snowhoster/MAVLinkController/docs/images/thumb_xh254_connectors.jpg

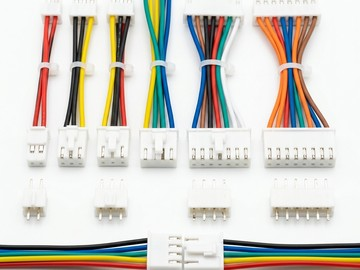
docs/images/thumb_xh254_connectors.jpg
