snowhoster/MAVLinkController/docs/images/thumb_arduino_uno.jpg

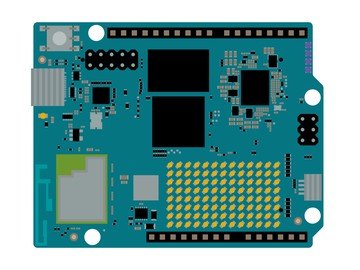
docs/images/thumb_arduino_uno.jpg
