snowhoster/MAVLinkController/docs/images/apem_sn.jpg

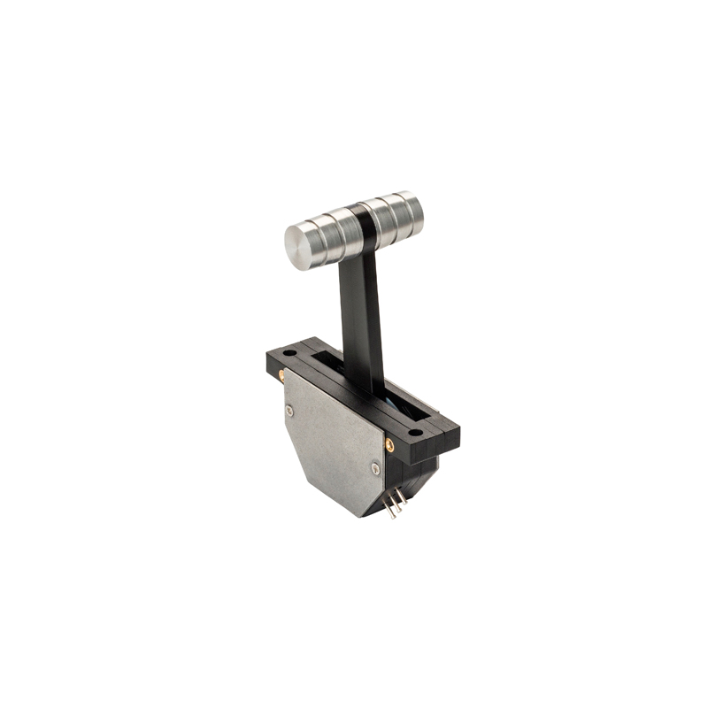
docs/images/apem_sn.jpg
