snowhoster/MAVLinkController/docs/images/arduino_uno.jpg

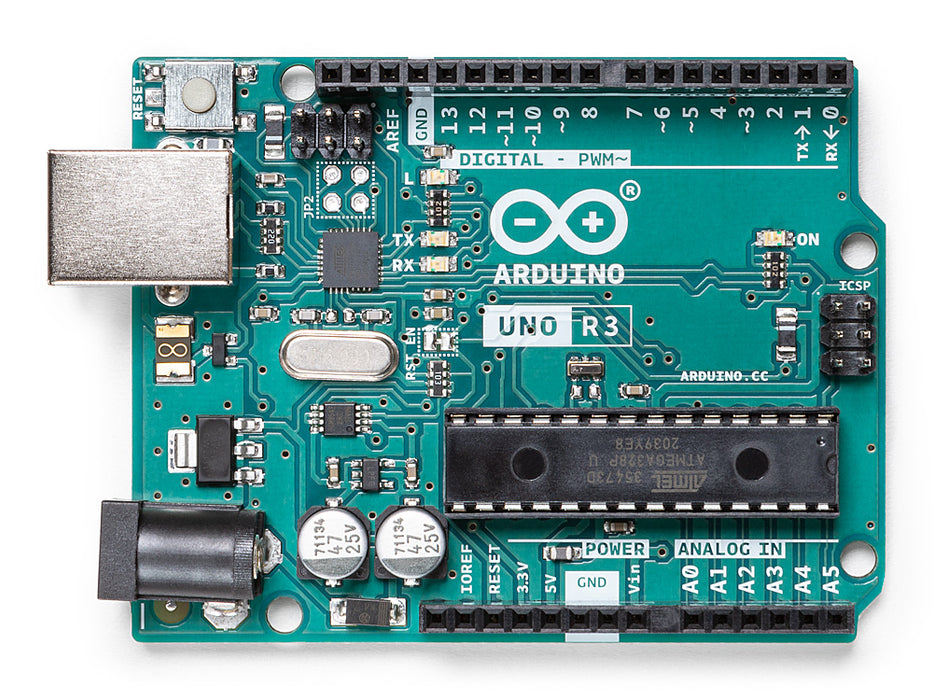
docs/images/arduino_uno.jpg
