snowhoster/MAVLinkController/docs/images/battery_18650.jpg

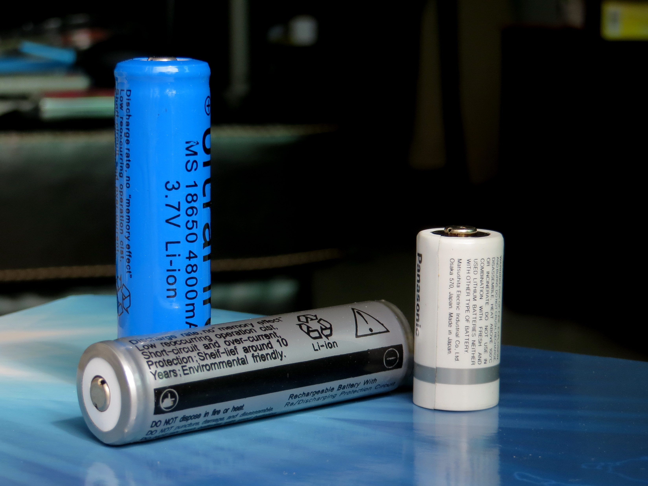
docs/images/battery_18650.jpg
