snowhoster/MAVLinkController/docs/images/battery_ups_module.jpg

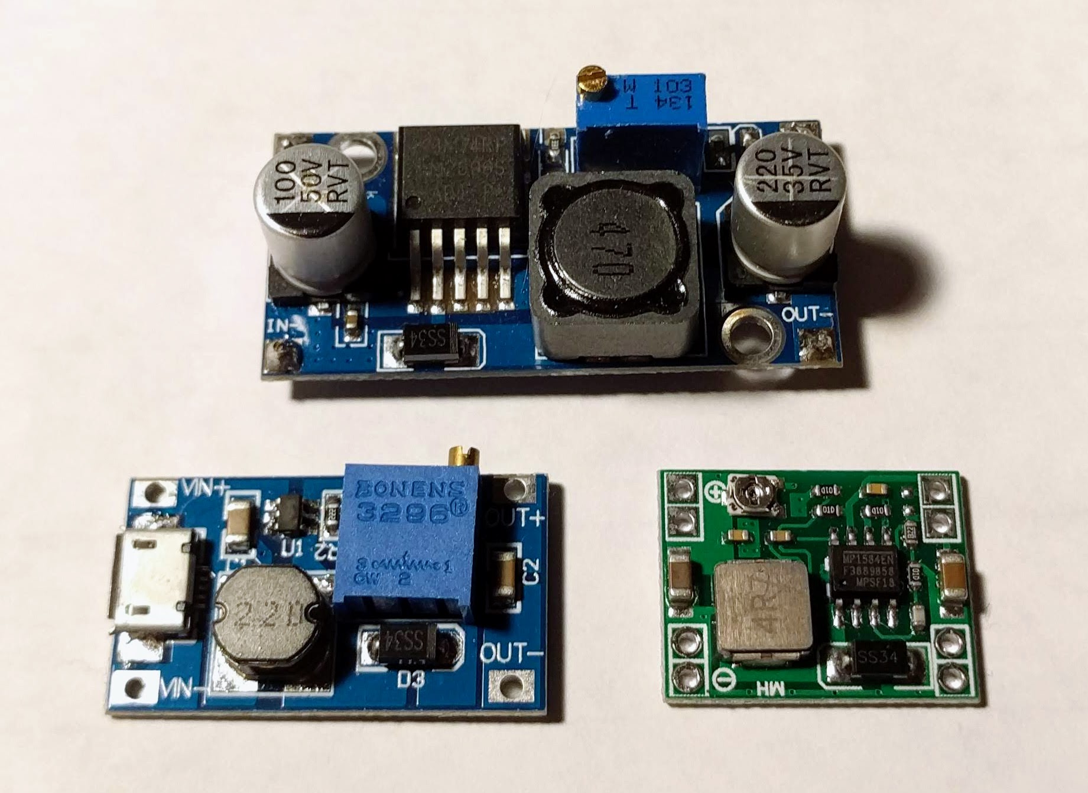
docs/images/battery_ups_module.jpg
