snowhoster/MAVLinkController/docs/images/capacitors.png

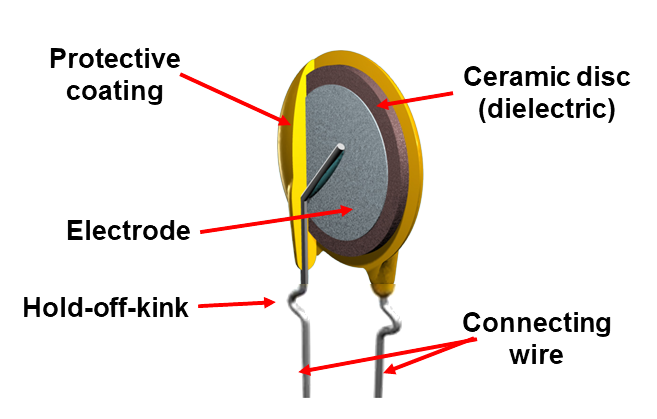
docs/images/capacitors.png
