snowhoster/MAVLinkController/docs/images/estop_button.jpg

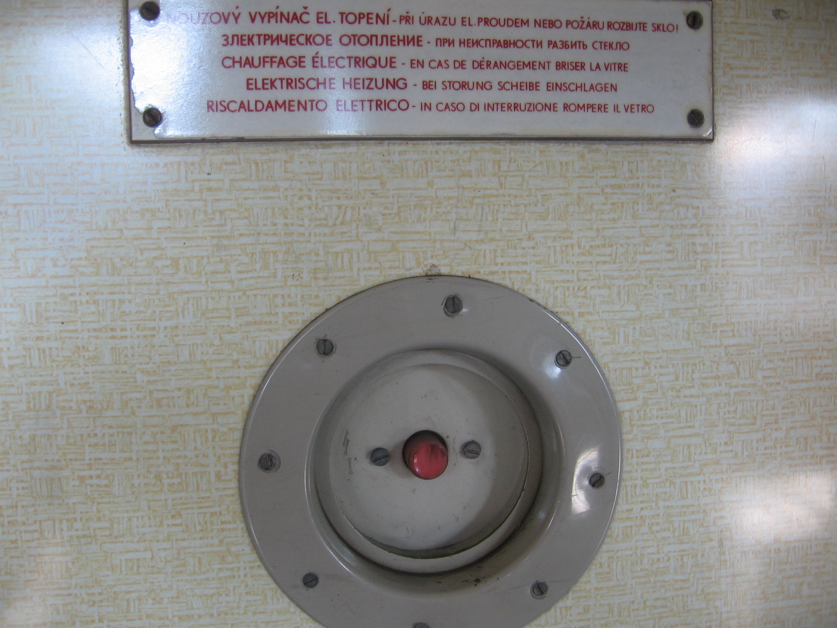
docs/images/estop_button.jpg
