snowhoster/MAVLinkController/docs/images/lcd1602.jpg

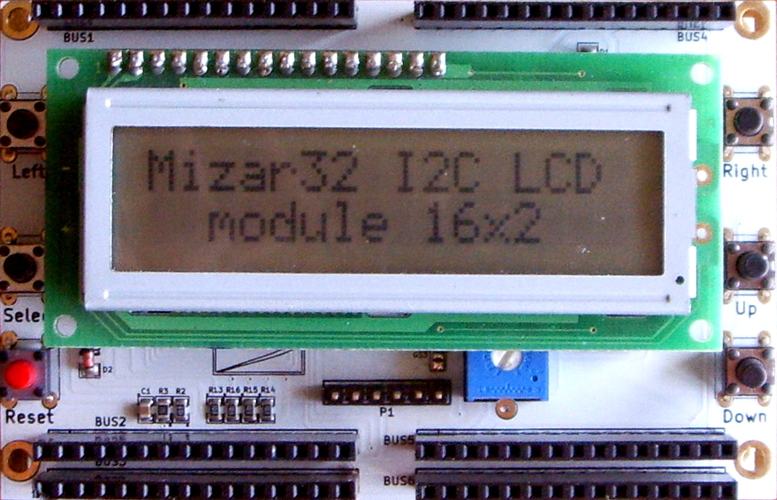
docs/images/lcd1602.jpg
