snowhoster/MAVLinkController/docs/images/mirotek_lcd_32.jpg

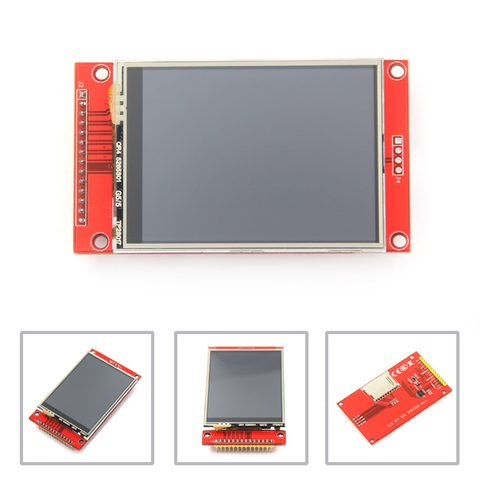
docs/images/mirotek_lcd_32.jpg
