snowhoster/MAVLinkController/docs/images/perfboard.jpg

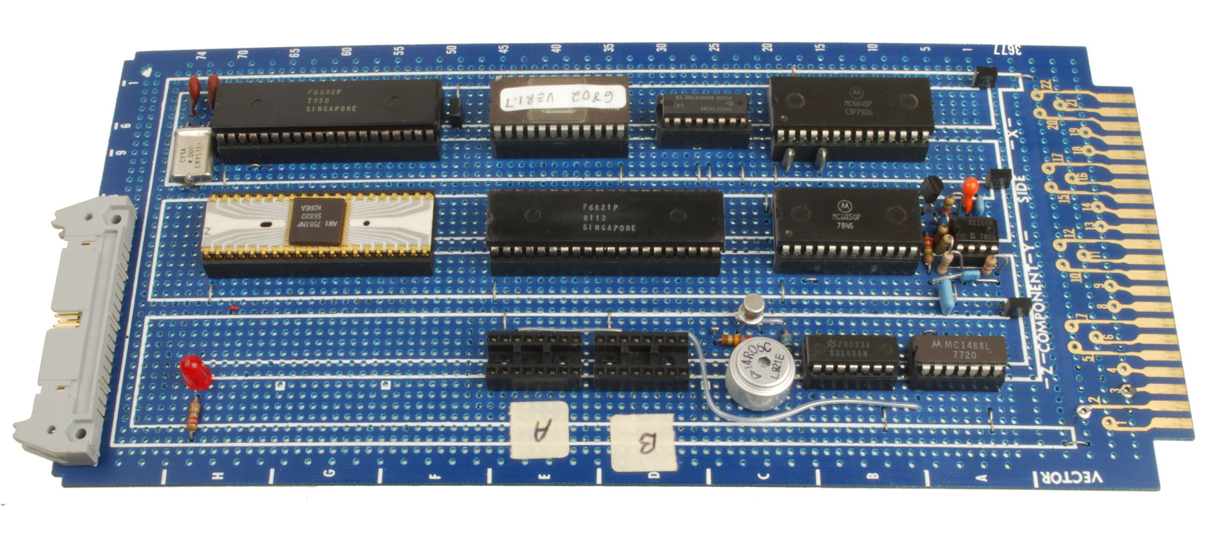
docs/images/perfboard.jpg
