snowhoster/MAVLinkController/docs/images/potentiometer.jpg

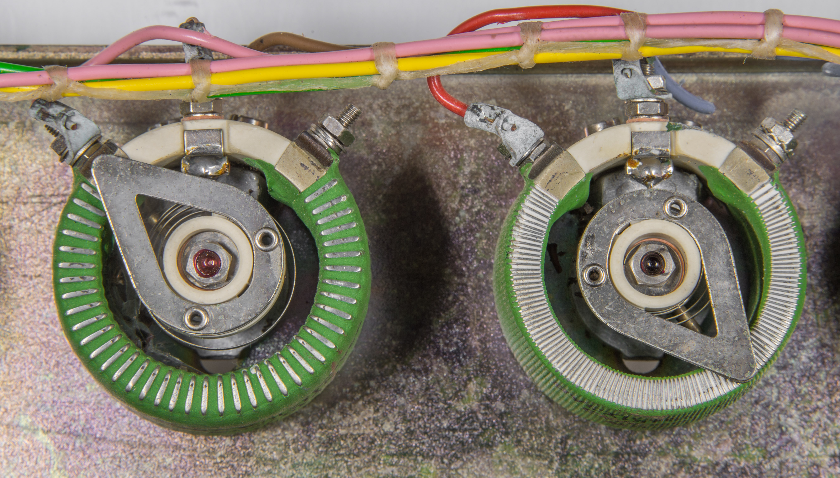
docs/images/potentiometer.jpg
