snowhoster/MAVLinkController/docs/images/resistors.jpg

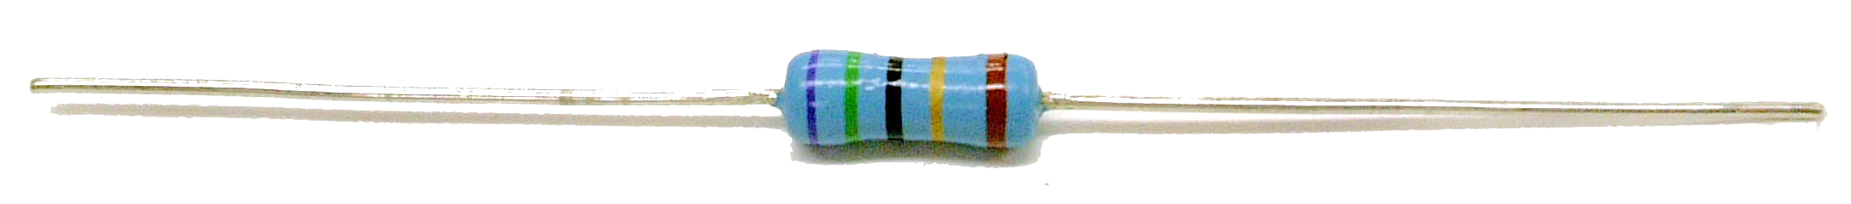
docs/images/resistors.jpg
