snowhoster/MAVLinkController/docs/images/thumb_apem_sn.jpg

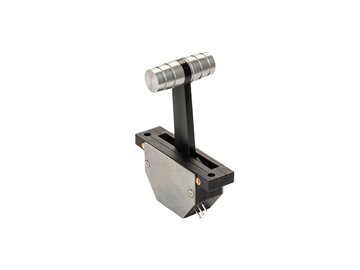
docs/images/thumb_apem_sn.jpg
