snowhoster/MAVLinkController/docs/images/thumb_battery_18650.jpg

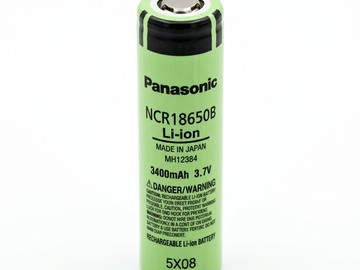
docs/images/thumb_battery_18650.jpg
