snowhoster/MAVLinkController/docs/images/thumb_battery_ups_module.jpg

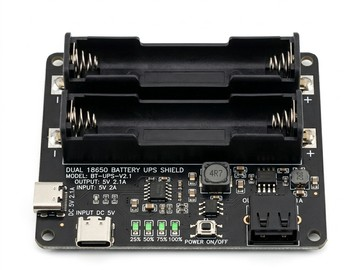
docs/images/thumb_battery_ups_module.jpg
