snowhoster/MAVLinkController/docs/images/thumb_capacitors.jpg

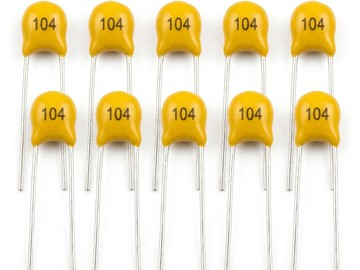
docs/images/thumb_capacitors.jpg
