snowhoster/MAVLinkController/docs/images/thumb_estop_button.jpg

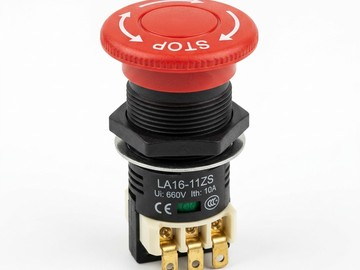
docs/images/thumb_estop_button.jpg
