snowhoster/MAVLinkController/docs/images/thumb_lcd1602.jpg

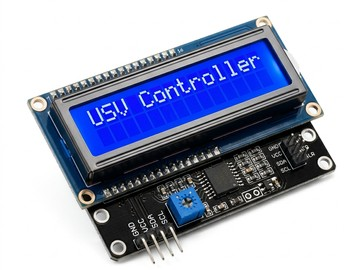
docs/images/thumb_lcd1602.jpg
