snowhoster/MAVLinkController/docs/images/thumb_perfboard.jpg

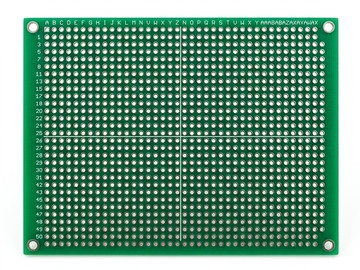
docs/images/thumb_perfboard.jpg
