snowhoster/MAVLinkController/docs/images/thumb_potentiometer.jpg

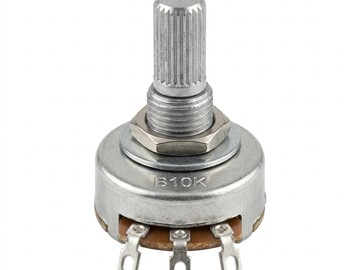
docs/images/thumb_potentiometer.jpg
