snowhoster/MAVLinkController/docs/images/thumb_resistors.jpg

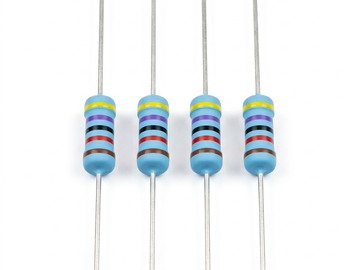
docs/images/thumb_resistors.jpg
