snowhoster/MAVLinkController/docs/images/thumb_typec_cable.jpg

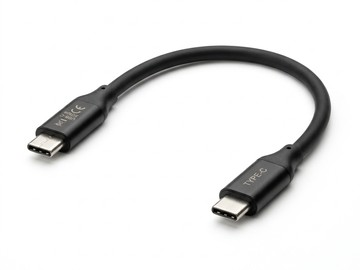
docs/images/thumb_typec_cable.jpg
