snowhoster/MAVLinkController/docs/images/typec_cable.jpg

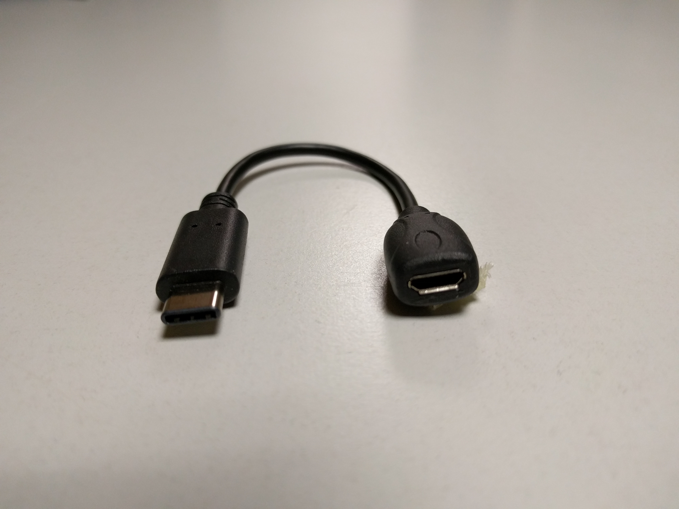
docs/images/typec_cable.jpg
