snowhoster/MAVLinkController/docs/images/xh254_connectors.jpg

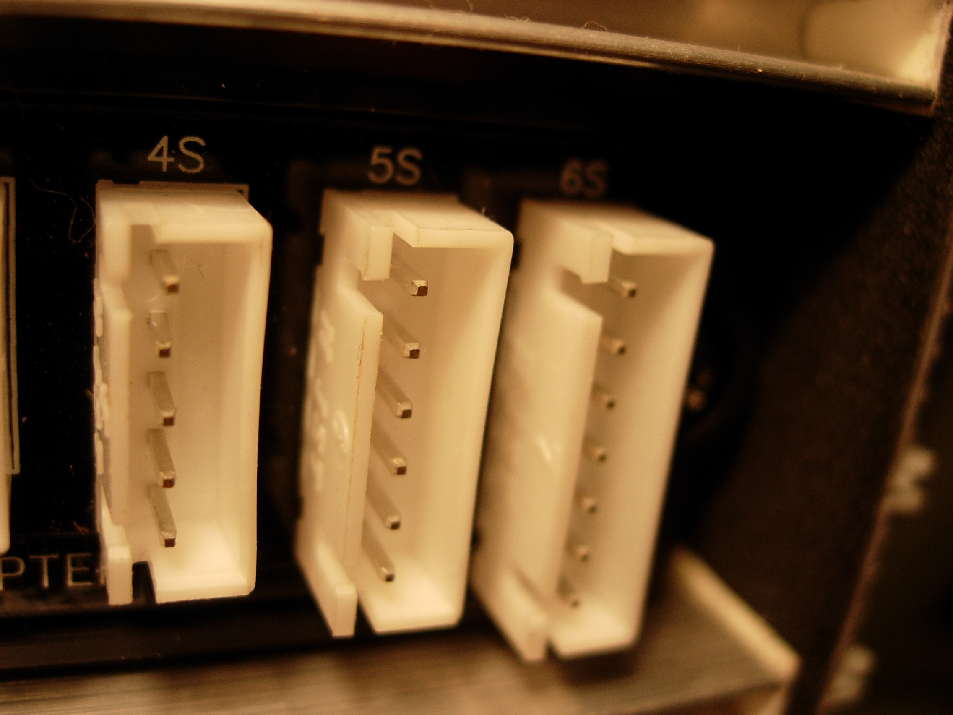
docs/images/xh254_connectors.jpg
