snowhoster/MAVLinkController/docs/hardware_diagram.pdf

# ⚓ USV 遙控器實物硬體架構與萬用洞洞板孔位施工全圖（方案 A：單主板直插 ＋ 雙 APEM SN 霍爾推桿）

### 📐 第一 頁 (A)：外殼機構與下方電路載板空間裝配關係圖 (正視橫向剖面

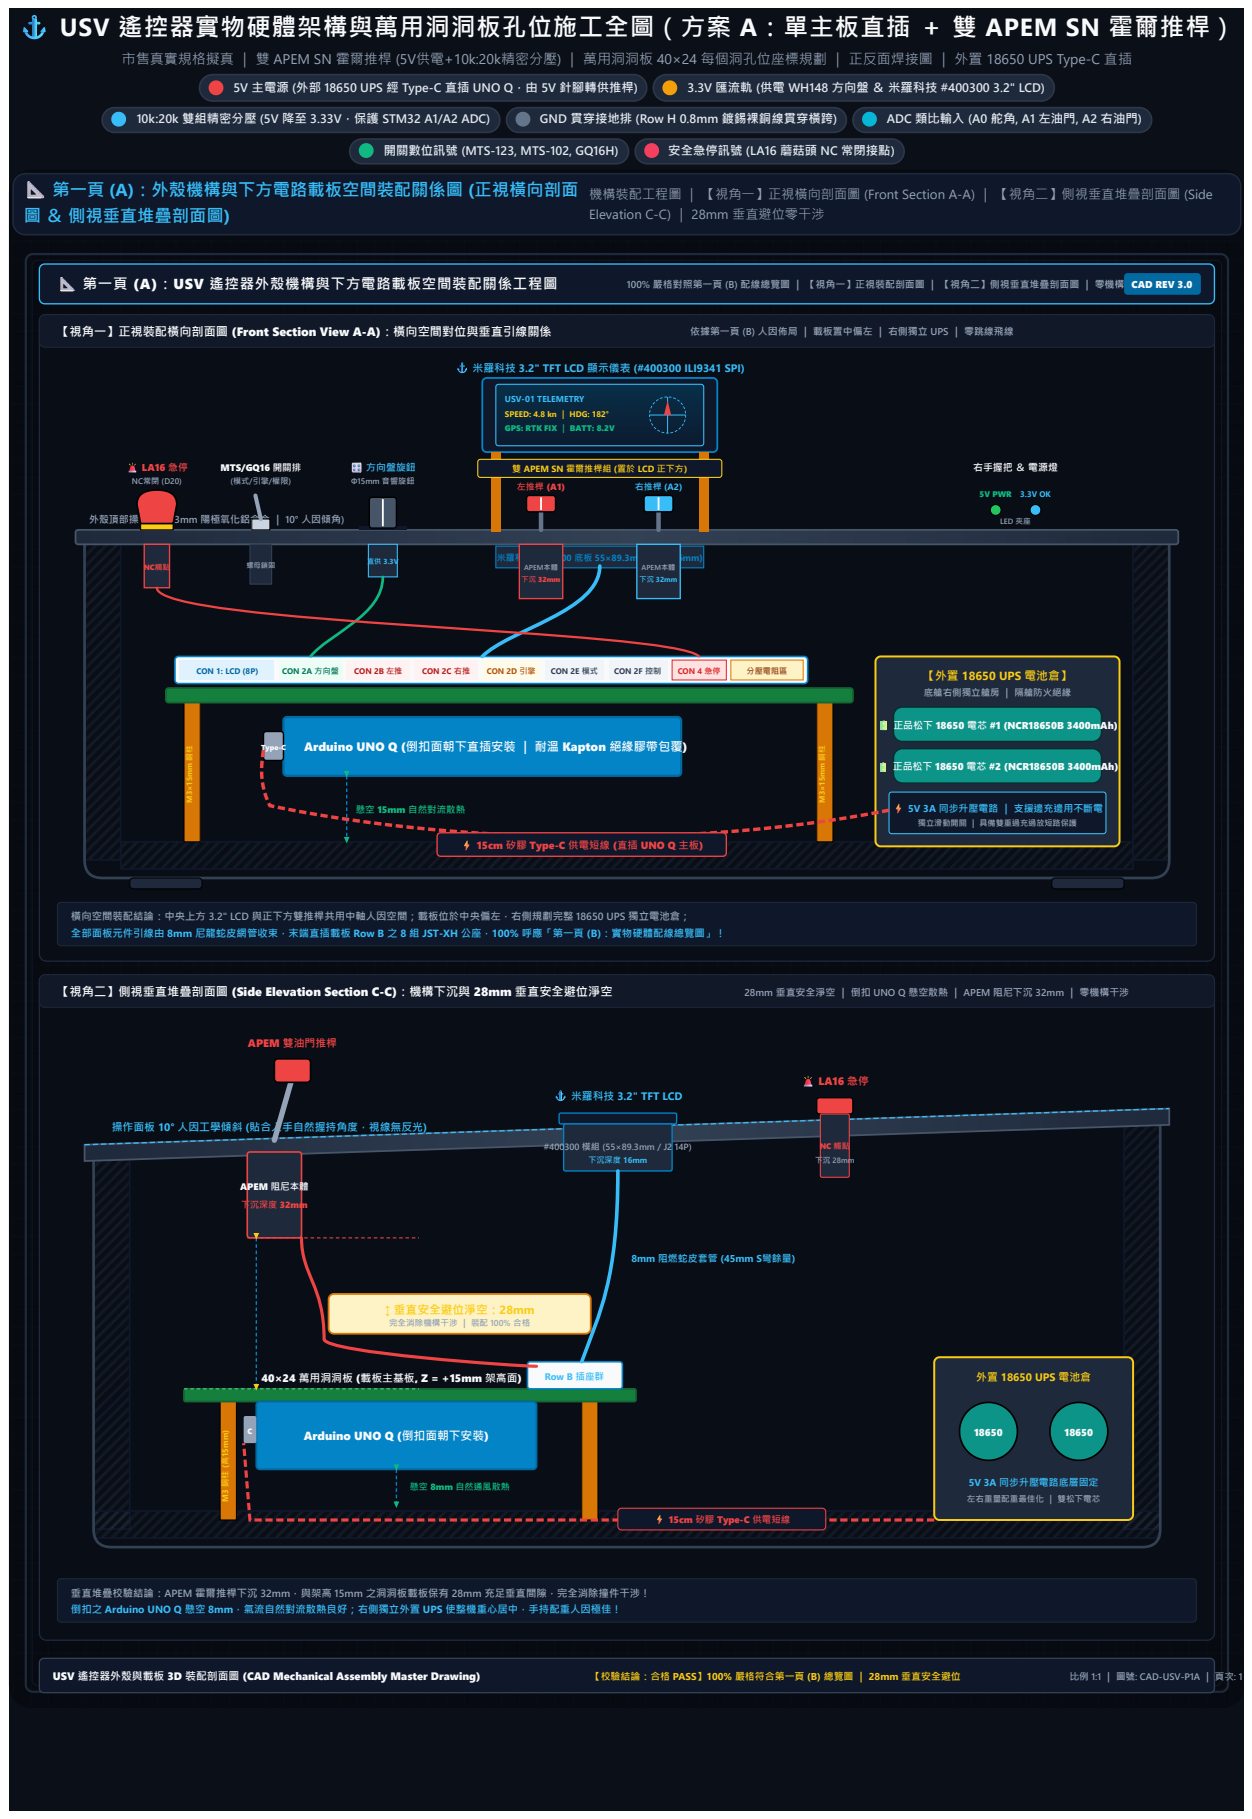
[picture p26: page 1]
5V 主電源 (外部 18650 UPS 經 Type-C 直插 UNO Q，由 5V 針腳轉供推桿); 3.3V 匯流軌 (供電 WH148 方向盤 ＆ 米羅科技 #400300 3.2" LCD); 10k:20k 雙組精密分壓 (5V 降至 3.33V，保護 STM32 A1/A2 ADC); GND 貫穿接地排 (Row H 0.8mm 鍍錫裸銅線貫穿橫跨); ADC 類比輸入 (A0 舵角, A1 左油門, A2 右油門); 開關數位訊號 (MTS-123, MTS-102, GQ16H); 安全急停訊號 (LA16 蘑菇頭 NC 常閉接點); 圖 ＆ 側視垂直堆疊剖面圖); 頁 (A)：USV 遙控器外殼機構與下方電路載板空間裝配關係工程圖; 100% 嚴格對照第一; 頁 (B) 配線總覽圖 ｜ 【視角一】正視裝配剖面圖 ｜ 【視角二】側視垂直堆疊剖面圖 ｜ 零機構干C涉AD REV 3.0; 【視角一】正視裝配橫向剖面圖 (Front Section View A-A)：橫向空間對位與垂直引線關係; 依據第一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

市售真實規格擬真 ｜ 雙 APEM SN 霍爾推桿 (5V供電+10k:20k精密分壓) ｜ 萬用洞洞板 40×24 每個洞孔位座標規劃 ｜ 正反面焊接圖 ｜ 外置 18650 UPS Type-C 直插

機構裝配工程圖 ｜ 【視角一】正視橫向剖面圖 (Front Section A-A) ｜ 【視角二】側視垂直堆疊剖面圖 (Side
Elevation C-C) ｜ 28mm 垂直避位零干涉

⚓ 米羅科技 3.2" TFT LCD 顯示儀表 (#400300 ILI9341 SPI)

USV-01 TELEMETRY
SPEED: 4.8 kn ｜ HDG: 182°
GPS: RTK FIX ｜ BATT: 8.2V

MTS/GQ16 開關排

雙 APEM SN 霍爾推桿組 (置於 LCD 正下方)
左推桿 (A1)

外殼頂部操作面板 (3mm 陽極氧化鋁合金 ｜ 10° 人因傾角)

米羅科技 #400300 底板 55×89.3mm (下沉 16mm)
APEM本體

40×24 萬用洞洞板 (載板主基板, 101.6mm × 61.0mm FR-4 玻纖板 ｜ M3 銅柱架高 15mm)

【外置 18650 UPS 電池倉】
底艙右側獨立艙房 ｜ 隔艙防火絕緣

⚡ 15cm 矽膠 Type-C 供電短線 (直插 UNO Q 主板)

橫向空間裝配結論：中央上方 3.2" LCD 與正下方雙推桿共用中軸人因空間；載板位於中央偏左，右側規劃完整 18650 UPS 獨立電池倉；

⚓ 米羅科技 3.2" TFT LCD

操作面板 10° 人因工學傾斜 (貼合人手自然握持角度，視線無反光)

↕ 垂直安全避位淨空：28mm
完全消除機構干涉 ｜ 裝配 100% 合格

外置 18650 UPS 電池倉

C Arduino UNO Q (倒扣面朝下安裝)

⚡ 15cm 矽膠 Type-C 供電短線

垂直堆疊校驗結論：APEM 霍爾推桿下沉 32mm，與架高 15mm 之洞洞板載板保有 28mm 充足垂直間隙，完全消除撞件干涉！
倒扣之 Arduino UNO Q 懸空 8mm，氣流自然對流散熱良好；右側獨立外置 UPS 使整機重心居中，手持配重人因極佳！

### 📄 第一 頁 (B)：USV 遙控器實物硬體配線總覽圖 (含外置 18650 UPS 電池倉、中間 3.2" LCD ＆ 雙 APEM 推桿、左側方向盤旋鈕)

人因工學佈局 ｜ 中間上方 3.2 吋 LCD ｜ 中間下方雙推桿 ｜ 左側方向盤旋鈕 ｜ 左 上角急停 ｜ 左側垂直平均開關排

【外殼頂部操作面板】(Top Control Panel — 中央儀表油門 ＋ 左側方向盤 ＋ 左側垂直控制排)
中間上方 3.2" LCD ｜ 中間下方雙油門推桿 ｜ 左側方向盤 ｜ 左上角急停 ｜ 左側垂直平均開關排

🚨 安全急停
LA16-11ZS
16mm 蘑菇頭
NC常閉 (D20)
NC1 NC2

🧭 模式切換
MTS-102 SPDT
撥上: 定向(ACRO)
撥下: 手動(MANUAL)

⚡ 雙引擎啟閉
MTS-123 SPDT
撥上: 啟動(ARM)
撥下: 熄火(DISARM)

🎮 控制權鍵
GQ16H-10 16mm
短按: 請求主控
長按2s: 釋放/復位

️ 方向盤旋鈕 (WH148 B10K)
Φ15mm×H13mm 調音台旋鈕帽 ｜ WH148 B10K

0° (正舵)

-30° | +30°
-45° | +45°

Φ15mm 調音台防滑旋鈕
直槽防滑條紋 ｜ 6mm花軸緊配合
Wiper 訊號直入 Arduino A0

3.3V ｜ Wiper ｜ GND

⚓ USV 遠端遙控器儀表台 (米羅科技 3.2" 320×240WILIIF9I:39481%) (-48dBm)

航速: 3.2 節 ｜ 航向: 045° ｜ GPS: 3D-Fix (14星)
電量: 98% (12.4V) ｜ 模式: 手動 (MANUAL)
引擎: ARMED (雙發運轉) ｜ 控制權: GRANTED
️ 舵角： | +12度 | (方向盤 WH148 → A0，±40度 左負右正)

左推力 [==== 65% ] ｜ 右推力 [==== 65% ]

SPI 介面 (J2 前8腳直插)：VCC, GND, CS(D10), RESET(D9), DC(D8), MOSI(D11), SCK(D13), LED(3.3V)

🚀 雙 APEM SN 工業級霍爾 T-Bar 油門推桿總成
非接觸霍爾 ｜ 鋼珠滾道 ｜ 12-bit 輸出 ｜ 5V 供電經 10k:20k 精密分壓保護

左油門 (Left Throttle)
輸出分壓至 A1 (0~3.33V)

100%

50%

0%

APEM SN

1: 5V(紅) | 2: OUT(黃) | 3: GND(黑)

XH-3P ➔ 洞洞板 10k:20k 分壓至 A1

右油門 (Right Throttle)
輸出分壓至 A2 (0~3.33V)

100%

50%

0%

APEM SN

1: 5V(紅) | 2: OUT(黃) | 3: GND(黑)

XH-3P ➔ 洞洞板 10k:20k 分壓至 A2

系統輔助區

右手防滑握持區
(橡膠壓花手柄)

5V 正常

3.3V 正常

⚡ 方向盤電位計接線

WH148 Pin1 → 3.3V
WH148 Pin3 → GND
Pin2 Wiper 0~3.3V
直入 Arduino A0
100nF 濾波 ｜ 3P 出線

吊帶防脫扣環
️ 人因工學線束規範：方向盤電位計 3.3V / Wiper / GND 三線經 8mm 蛇皮網直連洞洞板 CON 2A，與雙推桿 5V 訊號線分開走線避免耦合！

LCD 8P 專用線束
(面板 3.2" LCD ⟷ CON 1)

8mm 黑色高密尼龍蛇皮網管
集束方向盤、雙推桿、急停、模式、引擎等線束

【主機載板：40孔 × 24孔 萬用洞洞板】(2.54mm Pitch Carrier Motherboard)
尺寸 10×6cm ｜ 上緣集中焊接 8 組 JST-XH 公座 ｜ 直焊 10k:20k 1% 分壓 ｜ 倒扣插裝 UNO Q ｜ 18650電池外置不佔板面

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

【主機載板：40孔 × 52孔 萬用洞洞板】(Carrier Motherboard — 2.54mm Pitch)
板子尺寸約 10cm × 13cm。上方邊緣集中焊入 8 組 JST-XH2.54 直針公座；左側倒插 Arduino UNO Q，右側固定 18650 UPS；插座與主板間直焊 10k:20k 精密分壓電路。

CON 1: LCD
XH2.54 8P

CON 2A: 方向盤電位計
XH2.54 3P (A0)

CON 2B: 左油門
XH2.54 3P (APEM SN)

CON 2C: 右油門
XH2.54 3P (APEM SN)

CON 2D: 引擎
XH2.54 3P (A3/A4)

CON 2E: 模式
XH2.54 2P (D21)

CON 2F: 控制權
XH2.54 2P (A5)

CON 4: 急停
XH2.54 2P (D20 NC)

─ 5V 供電軌 (UPS 5V 供給 APEM 雙推桿 2B & 2C Pin 1) ─ 3.3V 匯流軌 (UNO Q 3.3V 供給 WH148 方向盤 2A) ─ GND 接地排 (底板鍍錫走線貫穿 2A~2F, CON4)

【萬用洞洞板實體焊接區：雙油門 10k:20k 1% 金屬膜分壓 ＋ 100nF RC 濾波】(直焊於插座與 Arduino 間) UPS 5V 軌

GND 貫穿接地排

R1: 10kΩ 1%

R2: 20kΩ 1% | 104 C1: 100nF
| 0~3.33V → A1

R3: 10kΩ 1%

R4: 20kΩ 1% | 104 C2: 100nF

0~3.33V → A2

104 C0: 100nF

0~3.3V → A0

【耐高溫金手指絕緣膠帶覆蓋區】(防止晶片焊點與底板短路)

### Arduino UNO Q (倒扣面朝下安裝)

雙核 STM32U585 M4 + Linux MPU (主板母座向下扣在洞洞板公排針上)

Type-C

微幅突出 2mm

8P 電源排針 (3.3V / GND) | 6P 類比排針 (A0 ~ A5)
A0 | A1 | A2 | A3 | A4 | A5

D0~D7 懸空不焊10P 數位排針 JDIGITAL Pin 18→9 (D21模式, D20急停, AREF, GND, D13~D8)

UNO Q 5V 針腳轉供推桿

【外置 18650 UPS 獨立電池倉】
置於機殼底槽專區 ｜ 獨立電池座 ｜ 不佔洞洞板面積
- 18650 動力鋰電池 #1 (3.7V 3000mAh) | +
- 18650 動力鋰電池 #2 (3.7V 3000mAh) | +

充放電與同步升壓保護板 (5V 3A)

Type-C 充電口 (外露)

支援邊充邊用

SW 開關焊點

實體總電源開關

5V 3A 供電輸出孔 (USB Type-C)

自帶過充、過放、過流、短路保護

⚡ 15cm 高規格短 Type-C 供電線 (外置電池直插 UNO Q)

💡 外置電池優勢：
1. 洞洞板面積節省 40%，載板小巧輕量
2. 可在外殼預留電池蓋，免拆機徒手換電池

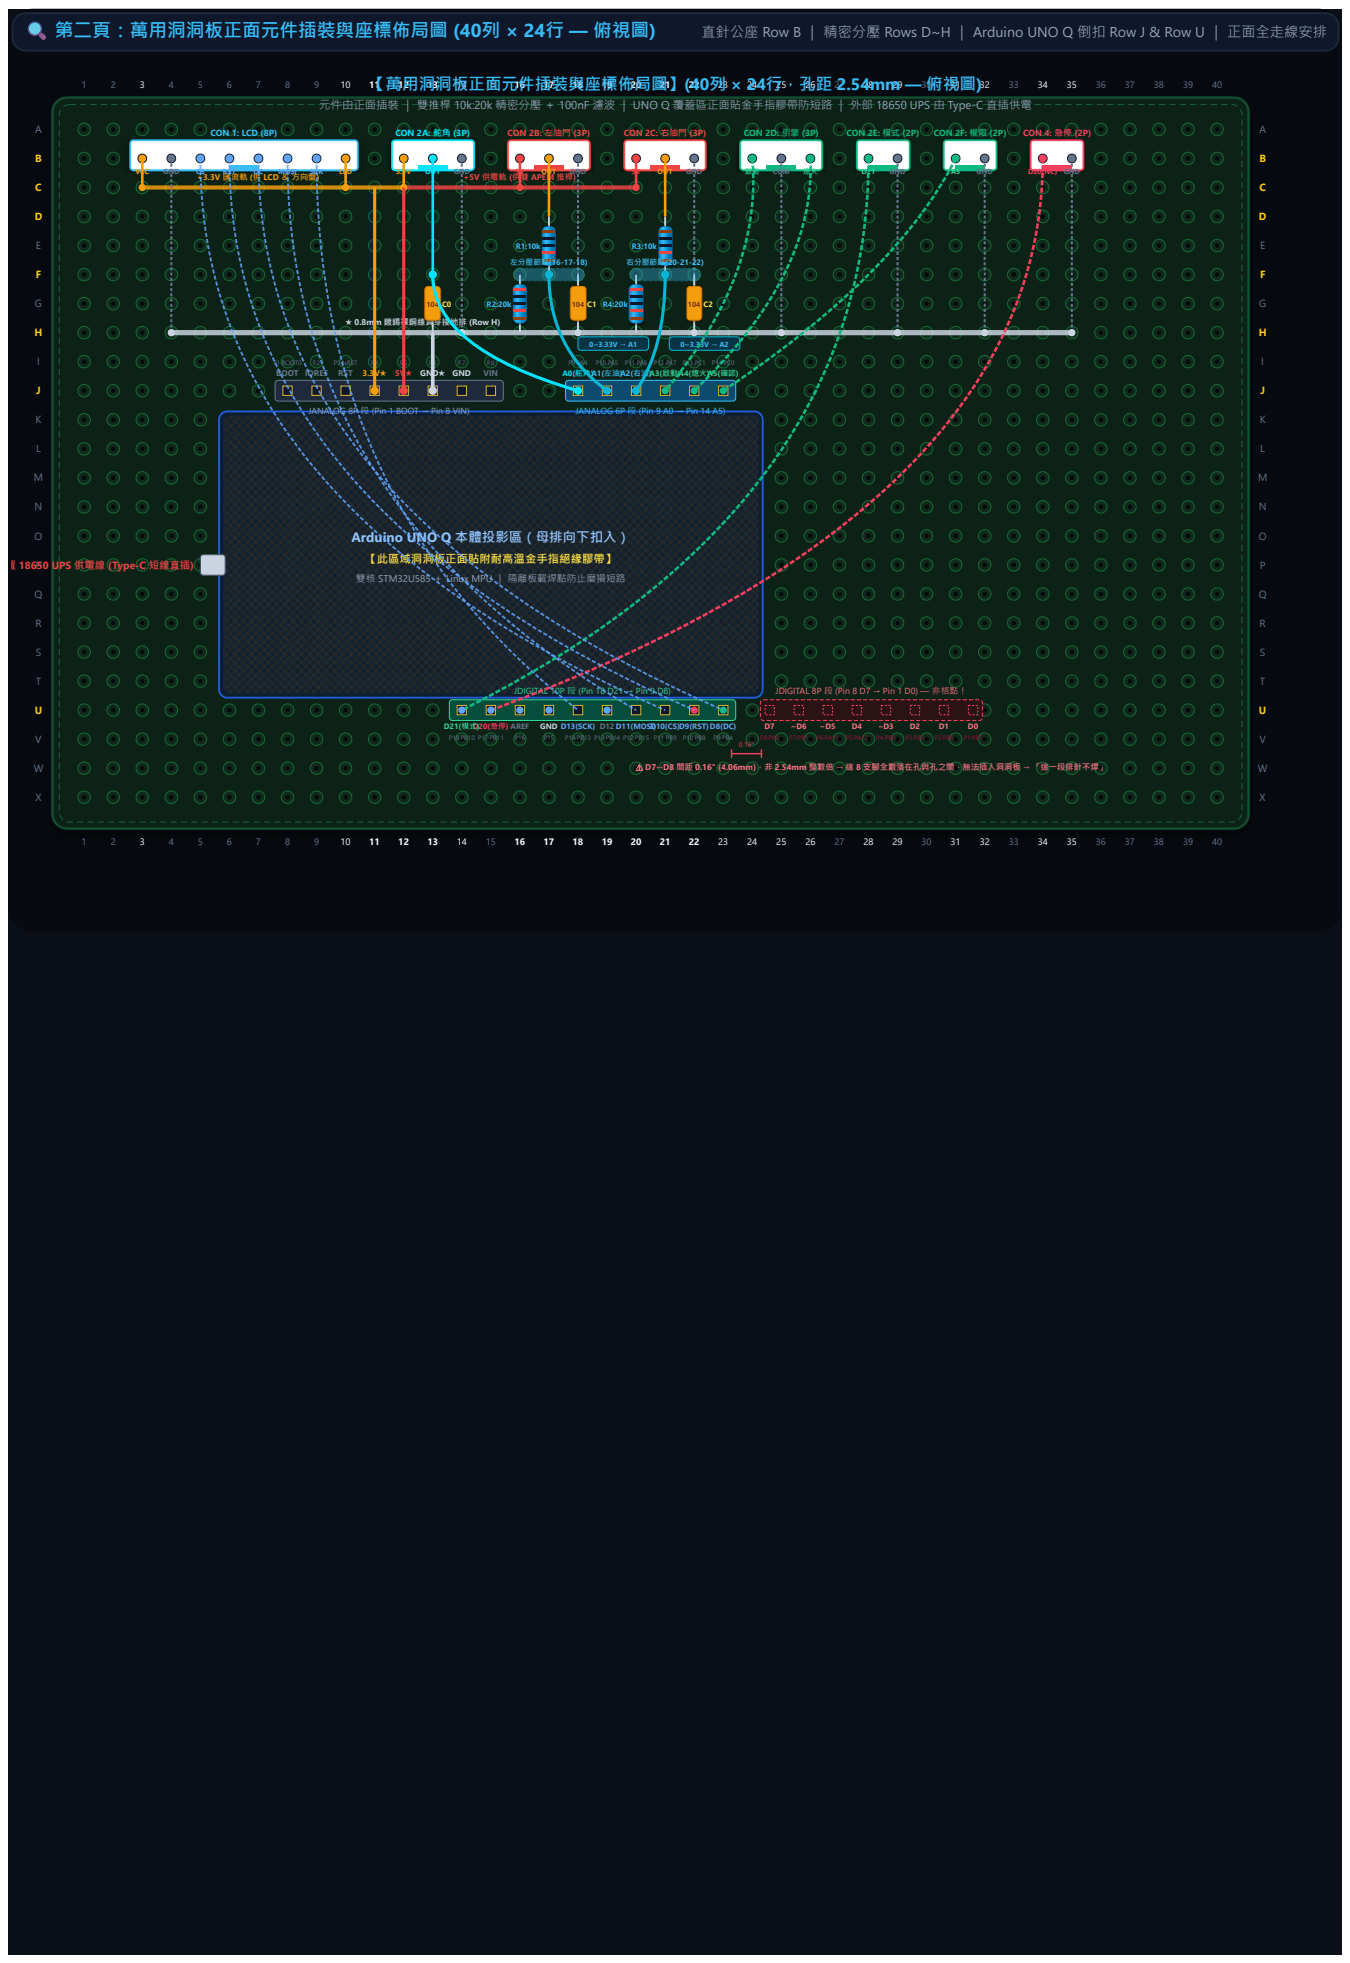
[picture p27: page 3]

元件由正面插裝 ｜ 雙推桿 10k:20k 精密分壓 ＋ 100nF 濾波 ｜ UNO Q 覆蓋區正面貼金手指膠帶防短路 ｜ 外部 18650 UPS 由 Type-C 直插供電

BOOT IOREF RST 3.3V★ 5V★ GND★ GND VIN

JANALOG 8P 段 (Pin 1 BOOT → Pin 8 VIN)

Arduino UNO Q 本體投影區（母排向下扣入）
【此區域洞洞板正面貼附耐高溫金手指絕緣膠帶】
雙核 STM32U585 ＋ Linux MPU ｜ 隔離板載焊點防止磨損短路

置 18650 UPS 供電線 (Type-C 短線直插)

JDIGITAL 8P 段 (Pin 8 D7 → Pin 1 D0) — 非格點！

D21(模式D)20(急停) AREF GND D13(SCK) D12 D11(MOSDI)10(CS)D9(RST)D8(DC)

⚠ D7↔D8 間距 0.16" (4.06mm)，非 2.54mm 整數倍 → 這 8 支腳全數落在孔與孔之間，無法插入洞洞板 → 「這一段排針不焊」

### 🔥 第三頁：萬用洞洞板背面實際焊接走線圖 (仰視鏡像：40Col ←

## 1Col)

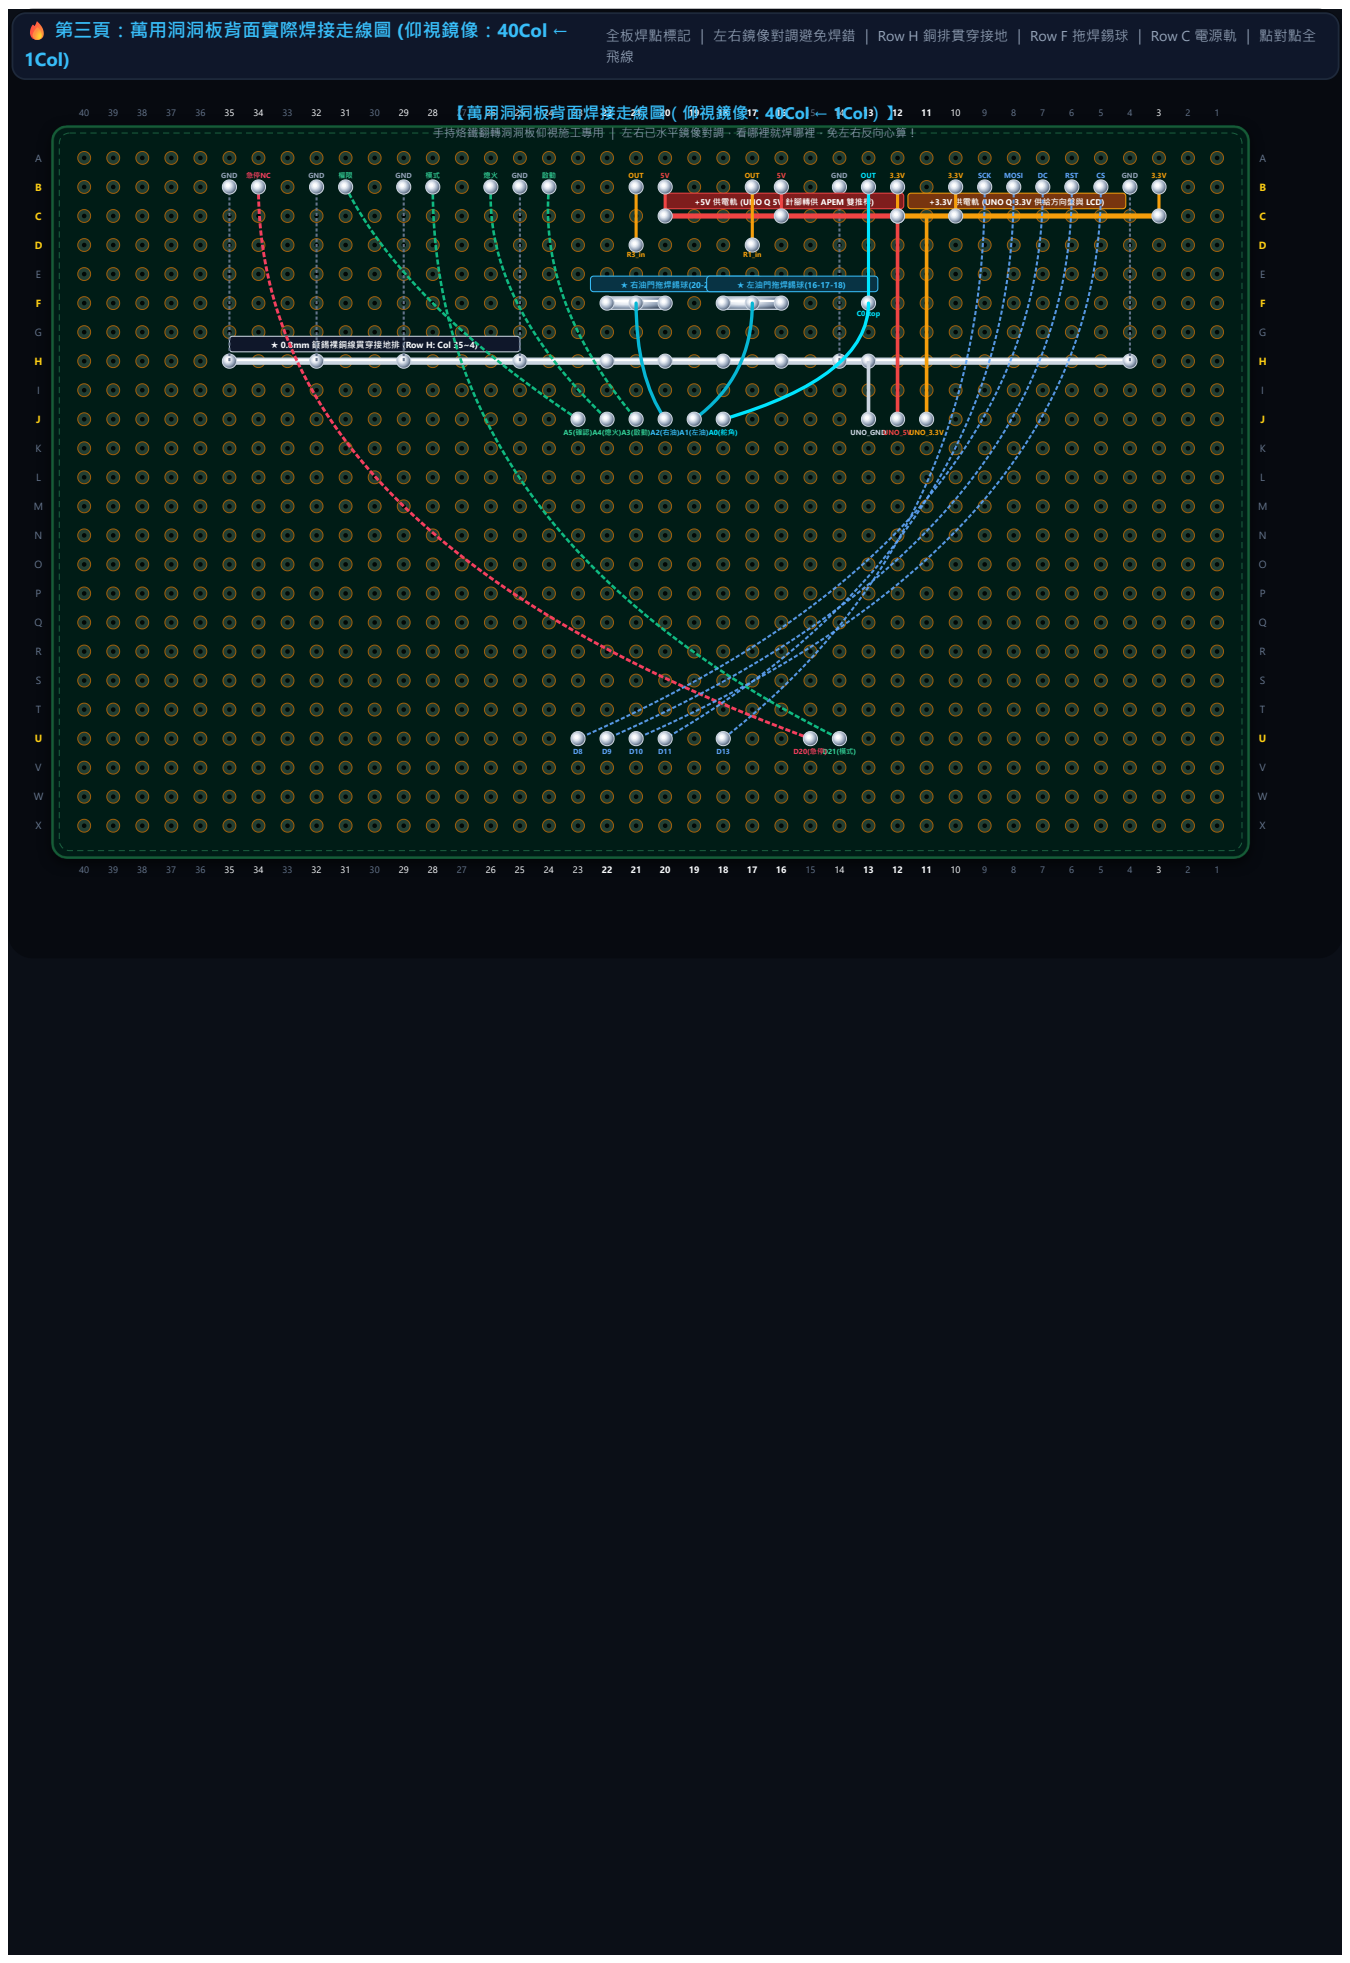
[picture p28: page 4]
GND; UNO_GND; UNO_5V; UNO_3.3V; ★ 右油門拖焊錫球(20-21-22); OUT; ★ 左油門拖焊錫球(16-17-18); C0_top; 急停NC; RST; MOSI; SCK; 【萬用洞洞板背面焊接走線圖（仰視鏡像：40Col ← 1Col）】

全板焊點標記 ｜ 左右鏡像對調避免焊錯 ｜ Row H 銅排貫穿接地 ｜ Row F 拖焊錫球 ｜ Row C 電源軌 ｜ 點對點全

手持烙鐵翻轉洞洞板仰視施工專用 ｜ 左右已水平鏡像對調，看哪裡就焊哪裡，免左右反向心算！

+5V 供電軌 (UNO Q 5V 針腳轉供 APEM 雙推桿)

+3.3V 供電軌 (UNO Q 3.3V 供給方向盤與 LCD)

★ 0.8mm 鍍錫裸銅線貫穿接地排 (Row H: Col 35~4)

📋 第四頁：萬用洞洞板 40×24 孔位座標電路明細表 (Master Hole-by-Hole Pinout Table) 40×24 每個孔位座標 ｜ 正背面鏡像對照 ｜ 針腳定義 ｜ 拖焊錫橋與接線工法

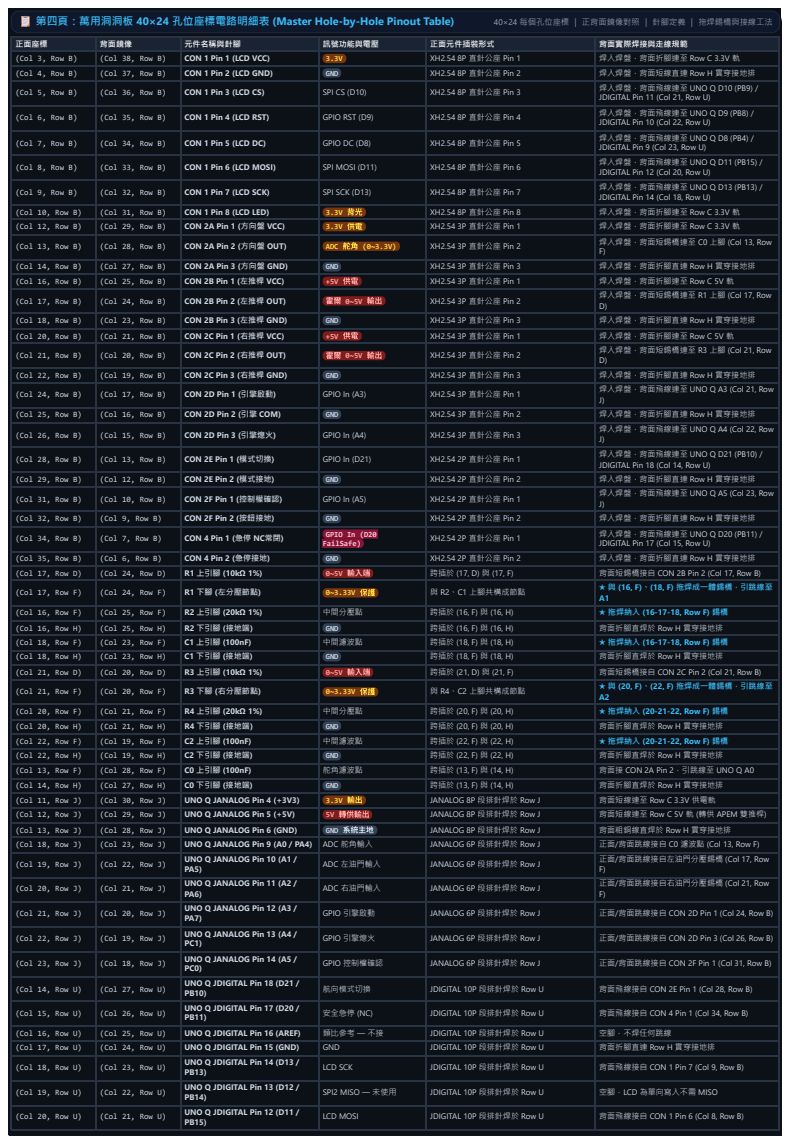
[picture p29: page 5]

正面座標 | 背面鏡像 | 元件名稱與針腳 | 訊號功能與電壓 | 正面元件插裝形式 | 背面實際焊接與走線規範
(Col 3, Row B) | (Col 38, Row B) | CON 1 Pin 1 (LCD VCC) | 3.3V | XH2.54 8P 直針公座 Pin 1 | 焊入焊盤，背面折腳連至 Row C 3.3V 軌
(Col 4, Row B) | (Col 37, Row B) | CON 1 Pin 2 (LCD GND) | GND | XH2.54 8P 直針公座 Pin 2 | 焊入焊盤，背面短線直連 Row H 貫穿接地排
(Col 5, Row B) | (Col 36, Row B) | CON 1 Pin 3 (LCD CS) | SPI CS (D10) | XH2.54 8P 直針公座 Pin 3 | 焊入焊盤，背面飛線連至 UNO Q D10 (PB9) / JDIGITAL Pin 11 (Col 21, Row U)

(Col 6, Row B) | (Col 35, Row B) | CON 1 Pin 4 (LCD RST) | GPIO RST (D9) | XH2.54 8P 直針公座 Pin 4 | 焊入焊盤，背面飛線連至 UNO Q D9 (PB8) / JDIGITAL Pin 10 (Col 22, Row U)

(Col 7, Row B) | (Col 34, Row B) | CON 1 Pin 5 (LCD DC) | GPIO DC (D8) | XH2.54 8P 直針公座 Pin 5 | 焊入焊盤，背面飛線連至 UNO Q D8 (PB4) / JDIGITAL Pin 9 (Col 23, Row U)

(Col 8, Row B) | (Col 33, Row B) | CON 1 Pin 6 (LCD MOSI) | SPI MOSI (D11) | XH2.54 8P 直針公座 Pin 6 | 焊入焊盤，背面飛線連至 UNO Q D11 (PB15) / JDIGITAL Pin 12 (Col 20, Row U)

(Col 9, Row B) | (Col 32, Row B) | CON 1 Pin 7 (LCD SCK) | SPI SCK (D13) | XH2.54 8P 直針公座 Pin 7 | 焊入焊盤，背面飛線連至 UNO Q D13 (PB13) / JDIGITAL Pin 14 (Col 18, Row U)

(Col 10, Row B) | (Col 31, Row B) | CON 1 Pin 8 (LCD LED) | 3.3V 背光 | XH2.54 8P 直針公座 Pin 8 | 焊入焊盤，背面折腳連至 Row C 3.3V 軌
(Col 12, Row B) | (Col 29, Row B) | CON 2A Pin 1 (方向盤 VCC) | 3.3V 供電 | XH2.54 3P 直針公座 Pin 1 | 焊入焊盤，背面折腳連至 Row C 3.3V 軌
(Col 13, Row B) | (Col 28, Row B) | CON 2A Pin 2 (方向盤 OUT) | ADC 舵角 (0~3.3V) | XH2.54 3P 直針公座 Pin 2 | 焊入焊盤，背面短錫橋連至 C0 上腳 (Col 13, Row F)

(Col 14, Row B) | (Col 27, Row B) | CON 2A Pin 3 (方向盤 GND) | GND | XH2.54 3P 直針公座 Pin 3 | 焊入焊盤，背面折腳直連 Row H 貫穿接地排
(Col 16, Row B) | (Col 25, Row B) | CON 2B Pin 1 (左推桿 VCC) | +5V 供電 | XH2.54 3P 直針公座 Pin 1 | 焊入焊盤，背面折腳連至 Row C 5V 軌
(Col 17, Row B) | (Col 24, Row B) | CON 2B Pin 2 (左推桿 OUT) | 霍爾 0~5V 輸出 | XH2.54 3P 直針公座 Pin 2 | 焊入焊盤，背面短錫橋連至 R1 上腳 (Col 17, Row D)

(Col 18, Row B) | (Col 23, Row B) | CON 2B Pin 3 (左推桿 GND) | GND | XH2.54 3P 直針公座 Pin 3 | 焊入焊盤，背面折腳直連 Row H 貫穿接地排
(Col 20, Row B) | (Col 21, Row B) | CON 2C Pin 1 (右推桿 VCC) | +5V 供電 | XH2.54 3P 直針公座 Pin 1 | 焊入焊盤，背面折腳連至 Row C 5V 軌
(Col 21, Row B) | (Col 20, Row B) | CON 2C Pin 2 (右推桿 OUT) | 霍爾 0~5V 輸出 | XH2.54 3P 直針公座 Pin 2 | 焊入焊盤，背面短錫橋連至 R3 上腳 (Col 21, Row D)

(Col 22, Row B) | (Col 19, Row B) | CON 2C Pin 3 (右推桿 GND) | GND | XH2.54 3P 直針公座 Pin 3 | 焊入焊盤，背面折腳直連 Row H 貫穿接地排
(Col 24, Row B) | (Col 17, Row B) | CON 2D Pin 1 (引擎啟動) | GPIO In (A3) | XH2.54 3P 直針公座 Pin 1 | 焊入焊盤，背面飛線連至 UNO Q A3 (Col 21, Row J)

(Col 25, Row B) | (Col 16, Row B) | CON 2D Pin 2 (引擎 COM) | GND | XH2.54 3P 直針公座 Pin 2 | 焊入焊盤，背面折腳直連 Row H 貫穿接地排
(Col 26, Row B) | (Col 15, Row B) | CON 2D Pin 3 (引擎熄火) | GPIO In (A4) | XH2.54 3P 直針公座 Pin 3 | 焊入焊盤，背面飛線連至 UNO Q A4 (Col 22, Row J)

(Col 28, Row B) | (Col 13, Row B) | CON 2E Pin 1 (模式切換) | GPIO In (D21) | XH2.54 2P 直針公座 Pin 1 | 焊入焊盤，背面飛線連至 UNO Q D21 (PB10) / JDIGITAL Pin 18 (Col 14, Row U)

(Col 29, Row B) | (Col 12, Row B) | CON 2E Pin 2 (模式接地) | GND | XH2.54 2P 直針公座 Pin 2 | 焊入焊盤，背面折腳直連 Row H 貫穿接地排
(Col 31, Row B) | (Col 10, Row B) | CON 2F Pin 1 (控制權確認) | GPIO In (A5) | XH2.54 2P 直針公座 Pin 1 | 焊入焊盤，背面飛線連至 UNO Q A5 (Col 23, Row J)

(Col 32, Row B) | (Col 9, Row B) | CON 2F Pin 2 (按鈕接地) | GND | XH2.54 2P 直針公座 Pin 2 | 焊入焊盤，背面折腳直連 Row H 貫穿接地排
(Col 34, Row B) | (Col 7, Row B) | CON 4 Pin 1 (急停 NC常閉) | FailSafe) GPIO In (D20 | XH2.54 2P 直針公座 Pin 1 | 焊入焊盤，背面飛線連至 UNO Q D20 (PB11) / JDIGITAL Pin 17 (Col 15, Row U)

(Col 35, Row B) | (Col 6, Row B) | CON 4 Pin 2 (急停接地) | GND | XH2.54 2P 直針公座 Pin 2 | 焊入焊盤，背面折腳直連 Row H 貫穿接地排
(Col 17, Row D) | (Col 24, Row D) | R1 上引腳 (10kΩ 1%) | 0~5V 輸入端 | 跨插於 (17, D) 與 (17, F) | 背面短錫橋接自 CON 2B Pin 2 (Col 17, Row B)
(Col 17, Row F) | (Col 24, Row F) | R1 下腳 (左分壓節點) | 0~3.33V 保護 | 與 R2、C1 上腳共構成節點 | ★ 與 (16, F)、(18, F) 拖焊成一體錫橋，引跳線至 A1

(Col 16, Row F) | (Col 25, Row F) | R2 上引腳 (20kΩ 1%) | 中間分壓點 | 跨插於 (16, F) 與 (16, H) | ★ 拖焊納入 (16-17-18, Row F) 錫橋
(Col 16, Row H) | (Col 25, Row H) | R2 下引腳 (接地端) | GND | 跨插於 (16, F) 與 (16, H) | 背面折腳直焊於 Row H 貫穿接地排
(Col 18, Row F) | (Col 23, Row F) | C1 上引腳 (100nF) | 中間濾波點 | 跨插於 (18, F) 與 (18, H) | ★ 拖焊納入 (16-17-18, Row F) 錫橋
(Col 18, Row H) | (Col 23, Row H) | C1 下引腳 (接地端) | GND | 跨插於 (18, F) 與 (18, H) | 背面折腳直焊於 Row H 貫穿接地排
(Col 21, Row D) | (Col 20, Row D) | R3 上引腳 (10kΩ 1%) | 0~5V 輸入端 | 跨插於 (21, D) 與 (21, F) | 背面短錫橋接自 CON 2C Pin 2 (Col 21, Row B)
(Col 21, Row F) | (Col 20, Row F) | R3 下腳 (右分壓節點) | 0~3.33V 保護 | 與 R4、C2 上腳共構成節點 | ★ 與 (20, F)、(22, F) 拖焊成一體錫橋，引跳線至 A2

(Col 20, Row F) | (Col 21, Row F) | R4 上引腳 (20kΩ 1%) | 中間分壓點 | 跨插於 (20, F) 與 (20, H) | ★ 拖焊納入 (20-21-22, Row F) 錫橋
(Col 20, Row H) | (Col 21, Row H) | R4 下引腳 (接地端) | GND | 跨插於 (20, F) 與 (20, H) | 背面折腳直焊於 Row H 貫穿接地排
(Col 22, Row F) | (Col 19, Row F) | C2 上引腳 (100nF) | 中間濾波點 | 跨插於 (22, F) 與 (22, H) | ★ 拖焊納入 (20-21-22, Row F) 錫橋
(Col 22, Row H) | (Col 19, Row H) | C2 下引腳 (接地端) | GND | 跨插於 (22, F) 與 (22, H) | 背面折腳直焊於 Row H 貫穿接地排
(Col 13, Row F) | (Col 28, Row F) | C0 上引腳 (100nF) | 舵角濾波點 | 跨插於 (13, F) 與 (14, H) | 背面接 CON 2A Pin 2，引跳線至 UNO Q A0
(Col 14, Row H) | (Col 27, Row H) | C0 下引腳 (接地端) | GND | 跨插於 (13, F) 與 (14, H) | 背面折腳直焊於 Row H 貫穿接地排
(Col 11, Row J) | (Col 30, Row J) | UNO Q JANALOG Pin 4 (+3V3) | 3.3V 輸出 | JANALOG 8P 段排針焊於 Row J | 背面短線連至 Row C 3.3V 供電軌
(Col 12, Row J) | (Col 29, Row J) | UNO Q JANALOG Pin 5 (+5V) | 5V 轉供輸出 | JANALOG 8P 段排針焊於 Row J | 背面短線連至 Row C 5V 軌 (轉供 APEM 雙推桿)
(Col 13, Row J) | (Col 28, Row J) | UNO Q JANALOG Pin 6 (GND) | GND 系統主地 | JANALOG 8P 段排針焊於 Row J | 背面粗銅線直焊於 Row H 貫穿接地排
(Col 18, Row J) | (Col 23, Row J) | UNO Q JANALOG Pin 9 (A0 / PA4) | ADC 舵角輸入 | JANALOG 6P 段排針焊於 Row J | 正面/背面跳線接自 C0 濾波點 (Col 13, Row F)
(Col 19, Row J) | (Col 22, Row J) | UNO Q JANALOG Pin 10 (A1 / PA5) | ADC 左油門輸入 | JANALOG 6P 段排針焊於 Row J | 正面/背面跳線接自左油門分壓錫橋 (Col 17, Row F)

(Col 20, Row J) | (Col 21, Row J) | UNO Q JANALOG Pin 11 (A2 / PA6) | ADC 右油門輸入 | JANALOG 6P 段排針焊於 Row J | 正面/背面跳線接自右油門分壓錫橋 (Col 21, Row F)

(Col 21, Row J) | (Col 20, Row J) | UNO Q JANALOG Pin 12 (A3 / PA7) | GPIO 引擎啟動 | JANALOG 6P 段排針焊於 Row J | 正面/背面跳線接自 CON 2D Pin 1 (Col 24, Row B)

(Col 22, Row J) | (Col 19, Row J) | UNO Q JANALOG Pin 13 (A4 / PC1) | GPIO 引擎熄火 | JANALOG 6P 段排針焊於 Row J | 正面/背面跳線接自 CON 2D Pin 3 (Col 26, Row B)

(Col 23, Row J) | (Col 18, Row J) | UNO Q JANALOG Pin 14 (A5 / PC0) | GPIO 控制權確認 | JANALOG 6P 段排針焊於 Row J | 正面/背面跳線接自 CON 2F Pin 1 (Col 31, Row B)

(Col 14, Row U) | (Col 27, Row U) | UNO Q JDIGITAL Pin 18 (D21 / PB10) | 航向模式切換 | JDIGITAL 10P 段排針焊於 Row U | 背面飛線接自 CON 2E Pin 1 (Col 28, Row B)

(Col 15, Row U) | (Col 26, Row U) | UNO Q JDIGITAL Pin 17 (D20 / PB11) | 安全急停 (NC) | JDIGITAL 10P 段排針焊於 Row U | 背面飛線接自 CON 4 Pin 1 (Col 34, Row B)

(Col 16, Row U) | (Col 25, Row U) | UNO Q JDIGITAL Pin 16 (AREF) | 類比參考 — 不接 | JDIGITAL 10P 段排針焊於 Row U | 空腳，不焊任何跳線
(Col 17, Row U) | (Col 24, Row U) | UNO Q JDIGITAL Pin 15 (GND) | GND | JDIGITAL 10P 段排針焊於 Row U | 背面折腳直連 Row H 貫穿接地排
(Col 18, Row U) | (Col 23, Row U) | UNO Q JDIGITAL Pin 14 (D13 / PB13) | LCD SCK | JDIGITAL 10P 段排針焊於 Row U | 背面飛線接自 CON 1 Pin 7 (Col 9, Row B)

(Col 19, Row U) | (Col 22, Row U) | UNO Q JDIGITAL Pin 13 (D12 / PB14) | SPI2 MISO — 未使用 | JDIGITAL 10P 段排針焊於 Row U | 空腳，LCD 為單向寫入不需 MISO

(Col 20, Row U) | (Col 21, Row U) | UNO Q JDIGITAL Pin 12 (D11 / PB15) | LCD MOSI | JDIGITAL 10P 段排針焊於 Row U | 背面飛線接自 CON 1 Pin 6 (Col 8, Row B)

正 座 標 面 | 背 鏡 像 面 | 元 件 名 稱 與 針 腳 | 訊 號 功 能 與 電 壓 | 正 元 件 插 裝 形 式 面 | 背 實 際 焊 接 與 線 規 範 面 走
( C o l 2 1 , R o w U ) | ( C o l 2 0 , R o w U ) | U N O Q JDI G I TAL P i n 1 1 (D1 0 / P B 9 ) | L C D C S | J DIGITA L 1 0 P 段 排 針 焊 於 Row U | 背 面 飛 線 接 自 C O N 1 Pin 3 ( Col 5 , Row B )
( C o l 2 2 , R o w U ) | ( C o l 1 9 , R o w U ) | U N O Q JDI G I TAL P i n 1 0 (D9 / P B 8 ) | L C D RS T | J DIGITA L 1 0 P 段 排 針 焊 於 Row U | 背 面 飛 線 接 自 C O N 1 Pin 4 ( Col 6 , Row B )
( C o l 2 3 , R o w U ) | ( C o l 1 8 , R o w U ) | U N O Q JDI G I TAL P i n 9 (D8 / P B 4 ) | L C D D C | J DIGITA L 1 0 P 段 排 針 焊 於 Row U | 背 面 飛 線 接 自 C O N 1 Pin 5 ( Col 7 , Row B )

## 🔗 第四頁 (B)：韌體腳位 ↔ UNO Q 官方 Pinout ↔ STM32U585 MCU 腳名 總對

照表

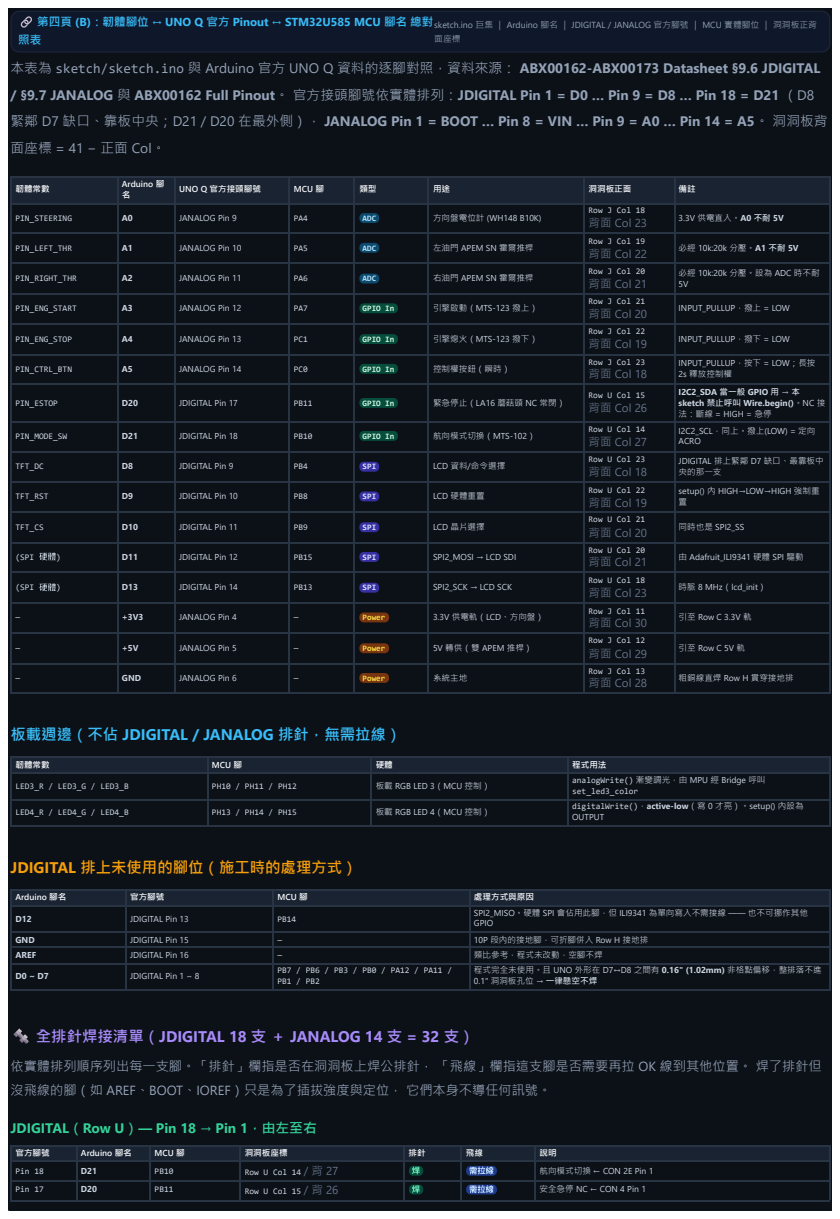
[picture p30: page 7]

sketch.ino 巨集 ｜ Arduino 腳名 ｜ JDIGITAL / JANALOG 官方腳號 ｜ MCU 實體腳位 ｜ 洞洞板正背
面座標

本表為 sketch/sketch.ino 與 Arduino 官方 UNO Q 資料的逐腳對照，資料來源： ABX00162-ABX00173 Datasheet §9.6 JDIGITAL
/ §9.7 JANALOG 與 ABX00162 Full Pinout。 官方接頭腳號依實體排列：JDIGITAL Pin 1 = D0 … Pin 9 = D8 … Pin 18 = D21 （D8
緊鄰 D7 缺口、靠板中央；D21 / D20 在最外側）， JANALOG Pin 1 = BOOT … Pin 8 = VIN … Pin 9 = A0 … Pin 14 = A5。 洞洞板背
面座標 = 41 − 正面 Col。

韌體常數 | Arduino 腳 名 | UNO Q 官方接頭腳號 | MCU 腳 | 類型 | 用途 | 洞洞板正面 | 備註

PIN_STEERING | A0 | JANALOG Pin 9 | PA4 | ADC | 方向盤電位計 (WH148 B10K) | Row J Col 18 背面 Col 23 | 3.3V 供電直入。A0 不耐 5V

PIN_LEFT_THR | A1 | JANALOG Pin 10 | PA5 | ADC | 左油門 APEM SN 霍爾推桿 | Row J Col 19 背面 Col 22 | 必經 10k:20k 分壓。A1 不耐 5V

PIN_RIGHT_THR | A2 | JANALOG Pin 11 | PA6 | ADC | 右油門 APEM SN 霍爾推桿 | Row J Col 20 背面 Col 21 | 必經 10k:20k 分壓。設為 ADC 時不耐 5V

PIN_ENG_START | A3 | JANALOG Pin 12 | PA7 | GPIO In | 引擎啟動（MTS-123 撥上） | Row J Col 21 背面 Col 20 | INPUT_PULLUP，撥上 = LOW

PIN_ENG_STOP | A4 | JANALOG Pin 13 | PC1 | GPIO In | 引擎熄火（MTS-123 撥下） | Row J Col 22 背面 Col 19 | INPUT_PULLUP，撥下 = LOW

PIN_CTRL_BTN | A5 | JANALOG Pin 14 | PC0 | GPIO In | 控制權按鈕（瞬時） | Row J Col 23 背面 Col 18 | INPUT_PULLUP，按下 = LOW；長按 2s 釋放控制權

PIN_ESTOP | D20 | JDIGITAL Pin 17 | PB11 | GPIO In | 緊急停止（LA16 蘑菇頭 NC 常閉） | Row U Col 15 背面 Col 26 | I2C2_SDA 當一般 GPIO 用 → 本 sketch 禁止呼叫 Wire.begin()。NC 接 法：斷線 = HIGH = 急停

PIN_MODE_SW | D21 | JDIGITAL Pin 18 | PB10 | GPIO In | 航向模式切換（MTS-102） | Row U Col 14 背面 Col 27 | I2C2_SCL，同上。撥上(LOW) = 定向 ACRO

TFT_DC | D8 | JDIGITAL Pin 9 | PB4 | SPI | LCD 資料/命令選擇 | Row U Col 23 背面 Col 18 | JDIGITAL 排上緊鄰 D7 缺口、最靠板中 央的那一 支

TFT_RST | D9 | JDIGITAL Pin 10 | PB8 | SPI | LCD 硬體重置 | Row U Col 22 背面 Col 19 | setup() 內 HIGH→LOW→HIGH 強制重 置

TFT_CS | D10 | JDIGITAL Pin 11 | PB9 | SPI | LCD 晶片選擇 | Row U Col 21 背面 Col 20 | 同時也是 SPI2_SS

(SPI 硬體) | D11 | JDIGITAL Pin 12 | PB15 | SPI | SPI2_MOSI → LCD SDI | Row U Col 20 背面 Col 21 | 由 Adafruit_ILI9341 硬體 SPI 驅動

(SPI 硬體) | D13 | JDIGITAL Pin 14 | PB13 | SPI | SPI2_SCK → LCD SCK | Row U Col 18 背面 Col 23 | 時脈 8 MHz（lcd_init）

— | +3V3 | JANALOG Pin 4 | — | Power | 3.3V 供電軌（LCD、方向盤） | Row J Col 11 背面 Col 30 | 引至 Row C 3.3V 軌

— | +5V | JANALOG Pin 5 | — | Power | 5V 轉供（雙 APEM 推桿） | Row J Col 12 背面 Col 29 | 引至 Row C 5V 軌

— | GND | JANALOG Pin 6 | — | Power | 系統主地 | Row J Col 13 背面 Col 28 | 粗銅線直焊 Row H 貫穿接地排

板載週邊（不佔 JDIGITAL / JANALOG 排針，無需拉線）

韌體常數 | MCU 腳 | 硬體 | 程式用法
LED3_R / LED3_G / LED3_B | PH10 / PH11 / PH12 | 板載 RGB LED 3（MCU 控制） | analogWrite() 漸變調光，由 MPU 經 Bridge 呼叫 set_led3_color

LED4_R / LED4_G / LED4_B | PH13 / PH14 / PH15 | 板載 RGB LED 4（MCU 控制） | digitalWrite()，active-low（寫 0 才亮）。setup() 內設為 OUTPUT

Arduino 腳名 | 官方腳號 | MCU 腳 | 處理方式與原因
D12 | JDIGITAL Pin 13 | PB14 | SPI2_MISO。硬體 SPI 會佔用此腳，但 ILI9341 為單向寫入不需接線 —— 也不可挪作其他 GPIO

GND | JDIGITAL Pin 15 | — | 10P 段內的接地腳，可折腳併入 Row H 接地排
AREF | JDIGITAL Pin 16 | — | 類比參考，程式未改動，空腳不焊
D0 ~ D7 | JDIGITAL Pin 1 ~ 8 | PB7 / PB6 / PB3 / PB0 / PA12 / PA11 / PB1 / PB2 | 程式完全未使用。且 UNO 外形在 D7↔D8 之間有 0.16" (1.02mm) 非格點偏移，整排落不進 0.1" 洞洞板孔位 → 一律懸空不焊

沒飛線的腳（如 AREF、BOOT、IOREF）只是為了插拔強度與定位， 它們本身不導任何訊號。

JDIGITAL（Row U）— Pin 18 → Pin 1，由左至右

官方腳號 | Arduino 腳名 | MCU 腳 | 洞洞板座標 | 排針 | 飛線 | 說明
Pin 18 | D21 | PB10 | Row U Col 14 / 背 27 | 焊 | 需拉線 | 航向模式切換 ← CON 2E Pin 1

Pin 17 | D20 | PB11 | Row U Col 15 / 背 26 | 焊 | 需拉線 | 安全急停 NC ← CON 4 Pin 1

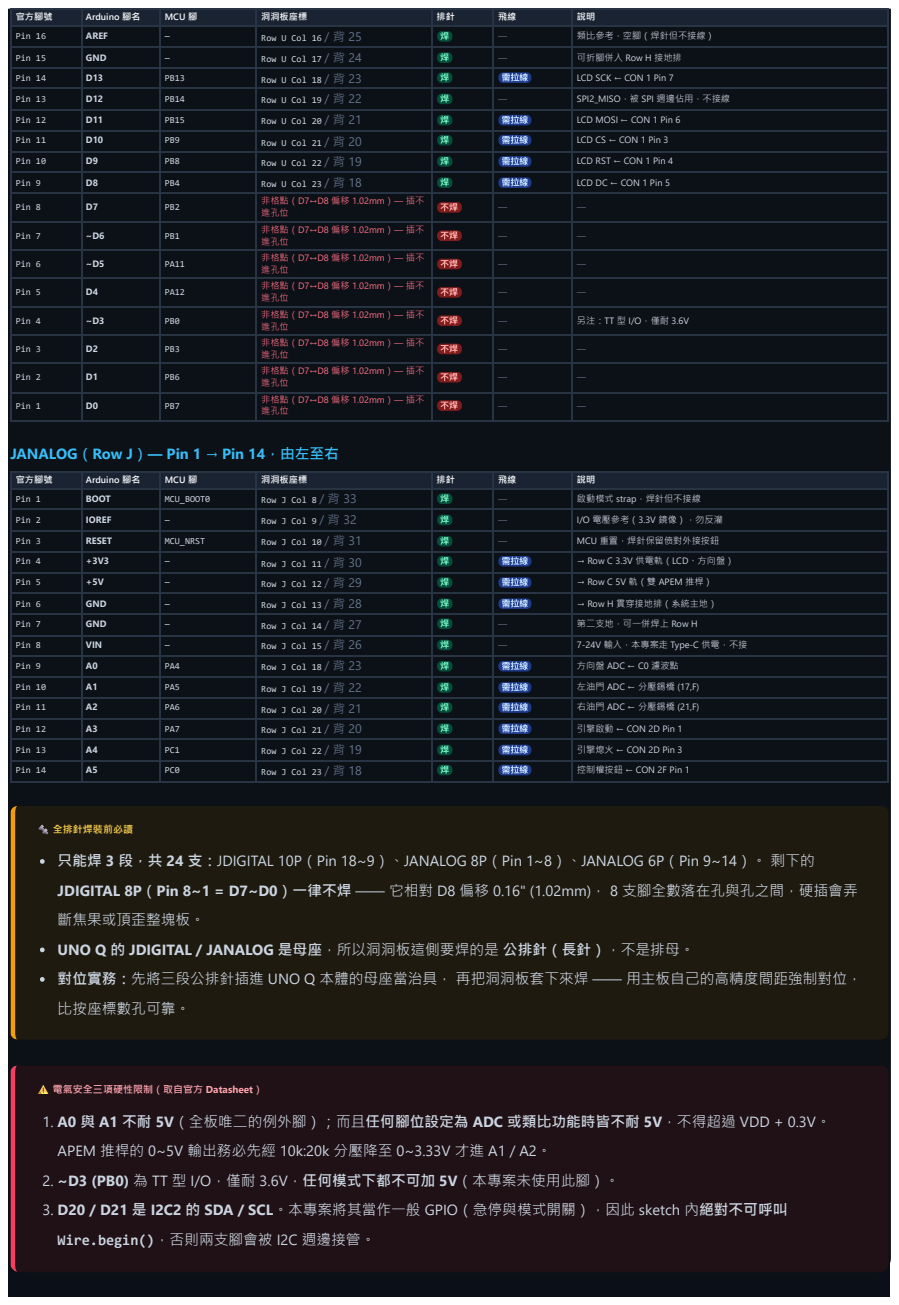
[picture p31: page 8]

官方腳號 | Arduino 腳名 | MCU 腳 | 洞洞板座標 | 排針 | 飛線 | 說明
Pin 16 | AREF | — | Row U Col 16 / 背 25 | 焊 | — | 類比參考，空腳（焊針但不接線）

Pin 15 | GND | — | Row U Col 17 / 背 24 | 焊 | — | 可折腳併入 Row H 接地排

Pin 14 | D13 | PB13 | Row U Col 18 / 背 23 | 焊 | 需拉線 | LCD SCK ← CON 1 Pin 7
Pin 13 | D12 | PB14 | Row U Col 19 / 背 22 | 焊 | — | SPI2_MISO，被 SPI 週邊佔用，不接線
Pin 12 | D11 | PB15 | Row U Col 20 / 背 21 | 焊 | 需拉線 | LCD MOSI ← CON 1 Pin 6

Pin 11 | D10 | PB9 | Row U Col 21 / 背 20 | 焊 | 需拉線 | LCD CS ← CON 1 Pin 3
Pin 10 | D9 | PB8 | Row U Col 22 / 背 19 | 焊 | 需拉線 | LCD RST ← CON 1 Pin 4

Pin 9 | D8 | PB4 | Row U Col 23 / 背 18 | 焊 | 需拉線 | LCD DC ← CON 1 Pin 5
Pin 8 | D7 | PB2 | 非格點（D7↔D8 偏移 1.02mm）— 插不 進孔位 | 不焊 | — | —

Pin 7 | ~D6 | PB1 | 非格點（D7↔D8 偏移 1.02mm）— 插不 進孔位 | 不焊 | — | —

Pin 6 | ~D5 | PA11 | 非格點（D7↔D8 偏移 1.02mm）— 插不 進孔位 | 不焊 | — | —

Pin 5 | D4 | PA12 | 非格點（D7↔D8 偏移 1.02mm）— 插不 進孔位 | 不焊 | — | —

Pin 4 | ~D3 | PB0 | 非格點（D7↔D8 偏移 1.02mm）— 插不 進孔位 | 不焊 | — | 另注：TT 型 I/O，僅耐 3.6V

Pin 3 | D2 | PB3 | 非格點（D7↔D8 偏移 1.02mm）— 插不 進孔位 | 不焊 | — | —

Pin 2 | D1 | PB6 | 非格點（D7↔D8 偏移 1.02mm）— 插不 進孔位 | 不焊 | — | —

Pin 1 | D0 | PB7 | 非格點（D7↔D8 偏移 1.02mm）— 插不 進孔位 | 不焊 | — | —

JANALOG（Row J）— Pin 1 → Pin 14，由左至右

Pin 1 | BOOT | MCU_BOOT0 | Row J Col 8 / 背 33 | 焊 | — | 啟動模式 strap，焊針但不接線

Pin 2 | IOREF | — | Row J Col 9 / 背 32 | 焊 | — | I/O 電壓參考（3.3V 鏡像），勿反灌

Pin 3 | RESET | MCU_NRST | Row J Col 10 / 背 31 | 焊 | — | MCU 重置，焊針保留偾對外接按鈕
Pin 4 | +3V3 | — | Row J Col 11 / 背 30 | 焊 | 需拉線 | → Row C 3.3V 供電軌（LCD、方向盤）
Pin 5 | +5V | — | Row J Col 12 / 背 29 | 焊 | 需拉線 | → Row C 5V 軌（雙 APEM 推桿）

Pin 6 | GND | — | Row J Col 13 / 背 28 | 焊 | 需拉線 | → Row H 貫穿接地排（系統主地）

Pin 7 | GND | — | Row J Col 14 / 背 27 | 焊 | — | 第二支地，可一併焊上 Row H
Pin 8 | VIN | — | Row J Col 15 / 背 26 | 焊 | — | 7-24V 輸入，本專案走 Type-C 供電，不接

Pin 9 | A0 | PA4 | Row J Col 18 / 背 23 | 焊 | 需拉線 | 方向盤 ADC ← C0 濾波點

Pin 10 | A1 | PA5 | Row J Col 19 / 背 22 | 焊 | 需拉線 | 左油門 ADC ← 分壓錫橋 (17,F)

Pin 11 | A2 | PA6 | Row J Col 20 / 背 21 | 焊 | 需拉線 | 右油門 ADC ← 分壓錫橋 (21,F)
Pin 12 | A3 | PA7 | Row J Col 21 / 背 20 | 焊 | 需拉線 | 引擎啟動 ← CON 2D Pin 1

Pin 13 | A4 | PC1 | Row J Col 22 / 背 19 | 焊 | 需拉線 | 引擎熄火 ← CON 2D Pin 3

Pin 14 | A5 | PC0 | Row J Col 23 / 背 18 | 焊 | 需拉線 | 控制權按鈕 ← CON 2F Pin 1

🔩 全排針焊裝前必讀
只能焊 3 段，共 24 支：JDIGITAL 10P（Pin 18~9）、JANALOG 8P（Pin 1~8）、JANALOG 6P（Pin 9~14）。 剩下的
JDIGITAL 8P（Pin 8~1 = D7~D0）一律不焊 —— 它相對 D8 偏移 0.16" (1.02mm)， 8 支腳全數落在孔與孔之間，硬插會弄
斷焦果或頂歪整塊板。
UNO Q 的 JDIGITAL / JANALOG 是母座，所以洞洞板這側要焊的是 公排針（長針），不是排母。
對位實務：先將三段公排針插進 UNO Q 本體的母座當治具， 再把洞洞板套下來焊 —— 用主板自己的高精度間距強制對位，
比按座標數孔可靠。

⚠️ 電氣安全三項硬性限制（取自官方 Datasheet）
1. A0 與 A1 不耐 5V（全板唯二的例外腳）；而且任何腳位設定為 ADC 或類比功能時皆不耐 5V，不得超過 VDD + 0.3V。
APEM 推桿的 0~5V 輸出務必先經 10k:20k 分壓降至 0~3.33V 才進 A1 / A2。
2. ~D3 (PB0) 為 TT 型 I/O，僅耐 3.6V，任何模式下都不可加 5V（本專案未使用此腳）。
3. D20 / D21 是 I2C2 的 SDA / SCL。本專案將其當作一般 GPIO（急停與模式開關），因此 sketch 內絕對不可呼叫
Wire.begin()，否則兩支腳會被 I2C 週邊接管。

# ️ 萬用洞洞板四大焊接實務工法與檢驗規範

## 1. Row H 裸銅線貫穿接地工法： 選用 0.8mm 鍍錫裸銅線 拉直橫跨整

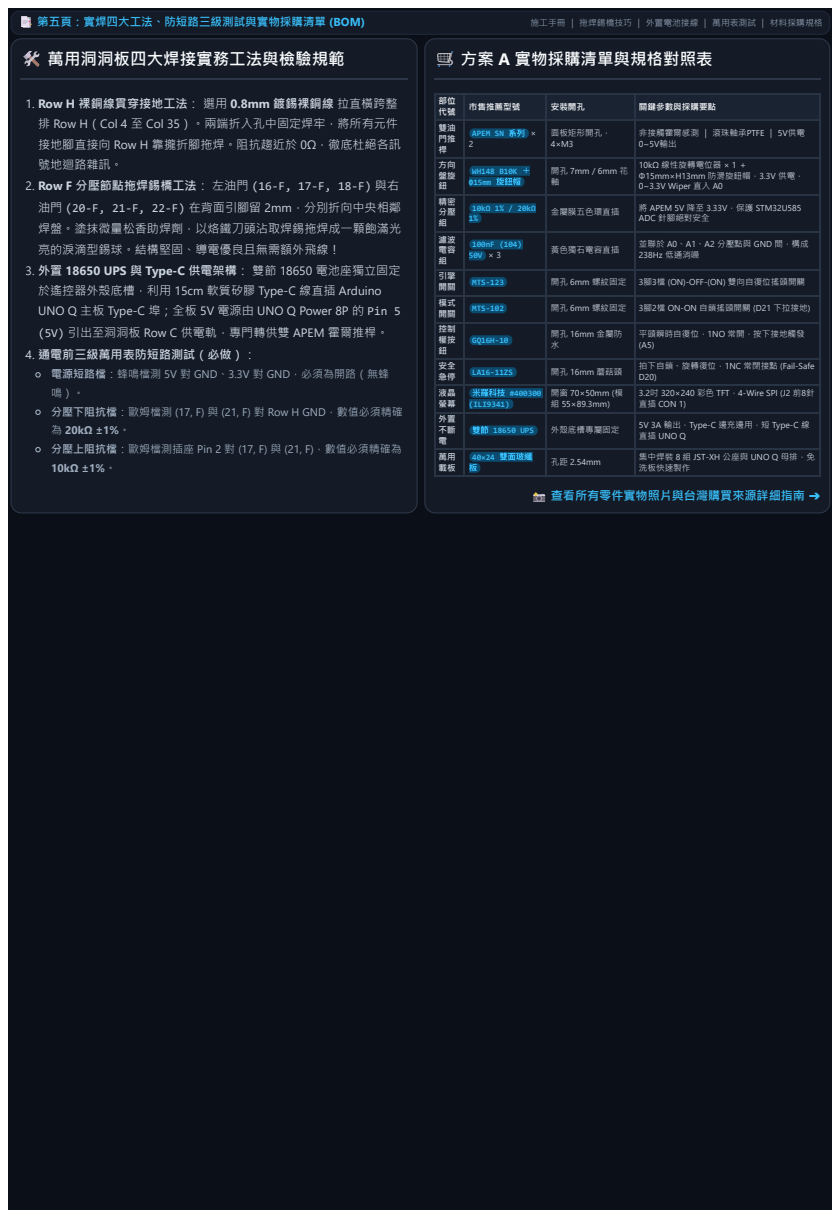
[picture p32: page 9]
📑 第五頁：實焊四大工法、防短路三級測試與實物採購清單 (BOM); 施工手冊 ｜ 拖焊錫橋技巧 ｜ 外置電池接線 ｜ 萬用表測試 ｜ 材料採購規格; 🛒 方案 A 實物採購清單與規格對照表; 📸 查看所有零件實物照片與台灣購買來源詳細指南 ➔

部位 代號 | 市售推薦型號 | 安裝開孔 | 關鍵參數與採購要點

排 Row H（Col 4 至 Col 35）。兩端折入孔中固定焊牢，將所有元件
接地腳直接向 Row H 靠攏折腳拖焊。阻抗趨近於 0Ω，徹底杜絕各訊
號地迴路雜訊。
2. Row F 分壓節點拖焊錫橋工法： 左油門 (16-F, 17-F, 18-F) 與右
油門 (20-F, 21-F, 22-F) 在背面引腳留 2mm，分別折向中央相鄰
焊盤。塗抹微量松香助焊劑，以烙鐵刀頭沾取焊錫拖焊成一顆飽滿光
亮的淚滴型錫球。結構堅固、導電優良且無需額外飛線！
3. 外置 18650 UPS 與 Type-C 供電架構： 雙節 18650 電池座獨立固定
於遙控器外殼底槽，利用 15cm 軟質矽膠 Type-C 線直插 Arduino
UNO Q 主板 Type-C 埠；全板 5V 電源由 UNO Q Power 8P 的 Pin 5
(5V) 引出至洞洞板 Row C 供電軌，專門轉供雙 APEM 霍爾推桿。
4. 通電前三級萬用表防短路測試（必做）：
電源短路檔：蜂鳴檔測 5V 對 GND、3.3V 對 GND，必須為開路（無蜂
分壓下阻抗檔：歐姆檔測 (17, F) 與 (21, F) 對 Row H GND，數值必須精確
分壓上阻抗檔：歐姆檔測插座 Pin 2 對 (17, F) 與 (21, F)，數值必須精確為

雙油 門推 桿 | APEM SN 系列 × 2 | 面板矩形開孔， 4×M3 | 非接觸霍爾感測 ｜ 滾珠軸承PTFE ｜ 5V供電 0~5V輸出

方向 盤旋 鈕 | WH148 B10K ＋ Φ15mm 旋鈕帽 | 開孔 7mm / 6mm 花 軸 | 10kΩ 線性旋轉電位器 × 1 ＋ Φ15mm×H13mm 防滑旋鈕帽，3.3V 供電， 0~3.3V Wiper 直入 A0

精密 分壓 組 | 10kΩ 1% / 20kΩ 1% | 金屬膜五色環直插 | 將 APEM 5V 降至 3.33V，保護 STM32U585 ADC 針腳絕對安全

濾波 電容 組 | 100nF (104) 50V × 3 | 黃色獨石電容直插 | 並聯於 A0、A1、A2 分壓點與 GND 間，構成 238Hz 低通消噪

引擎 開關 | MTS-123 | 開孔 6mm 螺紋固定 | 3腳3檔 (ON)-OFF-(ON) 雙向自復位搖頭開關

模式 開關 | MTS-102 | 開孔 6mm 螺紋固定 | 3腳2檔 ON-ON 自鎖搖頭開關 (D21 下拉接地)

控制 權按 鈕 | GQ16H-10 | 開孔 16mm 金屬防 水 | 平頭瞬時自復位，1NO 常開，按下接地觸發 (A5)

安全 急停 | LA16-11ZS | 開孔 16mm 蘑菇頭 | 拍下自鎖、旋轉復位，1NC 常閉接點 (Fail-Safe D20)

液晶 螢幕 | 米羅科技 #400300 (ILI9341) | 開窗 70×50mm (模 組 55×89.3mm) | 3.2吋 320×240 彩色 TFT，4-Wire SPI (J2 前8針 直插 CON 1)

外置 不斷 電 | 雙節 18650 UPS | 外殼底槽專屬固定 | 5V 3A 輸出，Type-C 邊充邊用，短 Type-C 線 直插 UNO Q

萬用 載板 | 板 40×24 雙面玻纖 | 孔距 2.54mm | 集中焊裝 8 組 JST-XH 公座與 UNO Q 母排，免 洗板快速製作

📸 第六頁：實物零件照片圖鑑與台灣採購指南（上篇：核心推桿、電控與電源載板） | 真實高解析照片 ｜ 規格對照 ｜ 台灣經銷商與代理直送 ｜ 採購防坑手冊
APEM SN 系列 霍爾 T-Bar 推桿 | APEM SN101SN
⚡ 核心規格：非接觸霍爾感測 ｜ 5V供電 0~5V類比輸出 ｜ 精密滾珠軸承 +PTFE導軌 ｜ 12-bit 解析度 ｜ 摩擦阻尼手感
📌 專案用途：接洞洞板 CON 2B & CON 2C 插座；左油門 A1、右油門 A2；經 10k:20k 精密分壓為 0~3.33V 保護 STM32 ADC

🛒 台灣推薦購買通路與搜尋關鍵字：
🔗 Mouser 貿澤電子 (台灣站)：搜尋「APEM (https://www.mouser.tw/) SN」或「SN101SN」（原廠授 權代理、台幣開立發票、空運直送到府）
🔗 DigiKey 得捷電子 (台灣站)：搜尋「APEM (https://www.digikey.tw/) SN series」（滿額免國際運 費、中文客服支援 0080-185-4023）

⚠️ 採購務必指名「類比電壓輸出 (0~5V Analog)」型號，切勿誤購 PWM 脈寬輸 出款！

Arduino UNO Q 主控開發板 Arduino UNO Q (STM32U585) ⚡ 核心規格：STM32U585 32-bit ARM Cortex-M33 ｜ 3.3V 邏輯電平 ｜ Type-C 供電燒錄 ｜ 標準 UNO R3 排針相容
📌 專案用途：直插於洞洞板排母；執行 Zephyr RTOS 多任務讀取 ADC 遙測、 MAVLink 協議封裝、I2C 螢幕驅動與 USB 通訊

🛒 台灣推薦購買通路與搜尋關鍵字：
🔗 ICShop 台灣物聯網：搜尋「Arduino (https://www.icshop.com.tw/) UNO」（義大利原廠正式授權代 理、現貨免等開立統編）
🔗 飆機器人 PlayRobot：搜尋「Arduino (https://www.playrobot.com/) 開發板」（創客正規經銷通路） 🔗 Mouser / DigiKey 台灣：原廠現貨庫存充足 (https://www.mouser.tw/)

💡 認明正式授權經銷正品，確保板載穩壓電路與 Zephyr RTOS / Arduino CLI 編 譯相容性。

5V 3A 雙節 18650 UPS 不斷電
模組

雙節 18650 充放電一體 UPS
板
⚡ 核心規格：雙節 18650 槽 ｜ Type-C 充放一體 ｜ 5V 3A 升壓穩壓輸出 ｜ 邊 充邊用無縫切換 ｜ 防過充放短路保護
📌 專案用途：獨立固定於遙控器外殼底層電池倉，以 15cm Type-C 短線直插 UNO Q 主板供電，不佔用洞洞板孔位

🛒 台灣推薦購買通路與搜尋關鍵字：
🔗 蝦皮購物 (台灣現貨專區)：搜尋「18650 (https://shopee.tw/) UPS 模組 5V 3A 雙節」或「充放 電一體 Type-C 5V」（出貨迅速）
🔗 露天市集 (台灣賣家)：搜尋「18650 (https://www.ruten.com.tw/) 不斷電模組 5V」
🔗 ICShop 台灣物聯網：搜尋「樹莓派 (https://www.icshop.com.tw/) UPS 模組 5V」

💡 選購時請挑選具備「常開不斷電版 (微電流不休眠)」，避免遙控器靜止待機時 誤判自動關機。

Panasonic NCR18650B 3400mAh 鋰電池

Panasonic NCR18650B
3.7V
⚡ 核心規格：標稱 3.7V / 3400mAh 大容量 ｜ 松下原裝高品質電芯 ｜ 無記憶 效應 ｜ 超長循環使用壽命
📌 專案用途：裝入底層 UPS 電池槽，提供全套遙控台與 LCD 螢幕超過 8~10 小 時連續不間斷野外作業續航

🛒 台灣推薦購買通路與搜尋關鍵字：
🔗 良興電子 (EcLife)：搜尋「Panasonic (https://www.eclife.com.tw/) 18650 BSMI」（台灣經濟部 BSMI 檢 驗合格）
🔗 PChome 24h / momo 購物網：搜尋「松下 (https://24h.pchome.com.tw/) 18650 BSMI 認證」
🔗 實體電子街門市：台北光華商場、源達科技、廣華電子門市現貨 (https://www.guanghua.tw/)

⚠️ 務必確認具有台灣「BSMI 檢驗認證字號」，切勿在拍賣平台購買價格異常低 廉的劣質二手拆機電池！

40×24孔 2.54mm FR-4 雙面
鍍錫洞洞板

FR-4 雙面噴錫玻纖板 (7×9cm
或 9×15cm)
⚡ 核心規格：2.54mm (100mil) 標準孔距 ｜ FR-4 高耐熱玻纖 ｜ 雙面防焊綠油/ 藍油 ｜ 雙面貫孔鍍錫 (PTH)
📌 專案用途：裁切為 40×24 孔使用。正面插裝排母與端子座，背面 Row H 裸 銅接地、Row F 拖焊錫橋、Row C 5V總線

🛒 台灣推薦購買通路與搜尋關鍵字：
🔗 良興電子 (EcLife)：搜尋「雙面 (https://www.eclife.com.tw/) 玻纖 萬用板 7x9」或「洞洞板 2.54」
🔗 ICShop 台灣物聯網：搜尋「雙面萬用板 (https://www.icshop.com.tw/) 2.54mm」
🔗 廣華電子商城：搜尋「雙面噴錫玻纖板」 (https://www.guanghua.tw/)
⚠️ 切勿購買廉價黃色「單面電木板」，務必指名「FR-4 雙面玻纖板」，焊接耐 高溫不脫焊盤！

USB Type-C 15cm 極短軟質供電傳
輸線

Type-C 公對公 15cm 超
短線
⚡ 核心規格：15cm ~ 20cm 極短長度 ｜ Type-C 公對公 ｜ 軟質抗折矽膠外被 ｜ 支援 5V 3A 大電流供電
📌 專案用途：連接控制器底層 18650 UPS 模組 Type-C 輸出孔與 Arduino UNO Q 主板 Type-C 供電孔

🛒 台灣推薦購買通路與搜尋關鍵字：
🔗 PChome 24h 購物：搜尋「Type-C (https://24h.pchome.com.tw/) 短線 15cm」（24 小時快速直送到 府）
🔗 良興電子 (EcLife)：搜尋「Type-C (https://www.eclife.com.tw/) 短傳輸線」
🔗 蝦皮購物 (台灣現貨)：搜尋「Type-C (https://shopee.tw/) 公對公 短線 15cm」

💡 線長切勿超過 20cm，避免在機殼內部造成線材盤繞擁擠，且能將電源傳輸阻 抗與壓降降至最低。

雙油推桿 (×2) | 主控制器 (×1) | 電源模組 (×1)
動電芯 (×2) | 萬載板 (×1) | 供電短線 (×1)

### 📸 第七頁：實物零件照片圖鑑與台灣採購指南（下篇：人機介面、分壓被動元件與線材） LCD 螢幕 ｜ 急停鈕 ｜ 搖頭開關 ｜ 精密電阻電容 ｜ 端子線材 ｜ 台灣現貨採購

### 3.2 吋 SPI TFT LCD 液晶螢幕模

組 (320×240 ILI9341)

米羅科技 Mirotek #400300
(ILI9341 / XPT2046)
⚡ 核心規格：3.2 吋 TFT ｜ 320×240 解析度 (RGB 65K 色) ｜ ILI9341 驅動 ｜ 4-Wire SPI ｜ 模組尺寸 55.04 × 89.30 mm ｜ 板載 3.3V LDO ｜ 邏輯電位 3.3V (UNO Q 原生相容)
📌 專案用途：以 XH2.54 8P (CON 1) 連接洞洞板 (J2 排針前 8 腳： VCC/GND/CS/RESET/DC/SDI/SCK/LED)；5Hz 高速即時顯示左右油門、舵角、羅 盤、電量與航行模式

🛒 台灣推薦購買通路與搜尋關鍵字：
🔗 米羅科技官方商城：料號「400300」（3.2吋 (https://shop.mirotek.com.tw/shop/400300/) TFT LCD 液晶螢幕模組 320x240 帶觸控功能 SPI，單價約 NT$350~420）
🔗 ICShop 台灣物聯網：搜尋「3.2吋 (https://www.icshop.com.tw/) TFT LCD SPI ILI9341」
🔗 蝦皮台灣賣家：搜尋「ILI9341 (https://shopee.tw/) 3.2吋 SPI 液晶屏 320x240」

💡 採購請指名米羅科技 #400300 或標準 14-Pin (J2) 模組。使用 J2 前 8 針直插 CON 1，UNO Q 具 3.3V 原生電位，免加裝電位轉換晶片。

LA16-11ZS 16mm 紅色自鎖急停
開關

LA16-11ZS / 16mm 蘑菇頭急
停鈕
⚡ 核心規格：16mm 面板開孔 ｜ 拍下自動鎖死 ｜ 順時針旋轉解鎖復位 ｜ 具 備 1NO (常開) + 1NC (常閉) 接點
📌 專案用途：採用 1NC 常閉接點接至 D20，斷線或按下即斷開接地觸發急停， 具備最高硬體失效安全防護 (Fail-Safe)

🛒 台灣推薦購買通路與搜尋關鍵字：
🔗 廣華電子商城：搜尋「LA16 (https://www.guanghua.tw/) 急停開關 16mm」
🔗 今華電子：搜尋「16mm (https://www.jin-hua.com.tw/) 蘑菇頭急停開關」
🔗 蝦皮購物 (台灣現貨)：搜尋「急停開關 (https://shopee.tw/) 16mm 自鎖」

⚠️ 接線前請以萬用電表蜂鳴檔測試合格，務必接在「NC (常閉)」接腳，開關拍 下時必須為斷路開路！

MTS-123 / MTS-102 迷你搖
頭開關

MTS-123 (雙自復位) / MTS-102
(自鎖)
⚡ 核心規格：6mm 螺紋開孔 ｜ 鍍鎳金屬撥桿 ｜ MTS-123 (雙自復位引擎啟閉 ×1) ｜ MTS-102 (模式切換 ×1)
📌 專案用途：MTS-123 上下撥動分別觸發 A3 左引擎與 A4 右引擎點火；MTS-102 撥動切換 D21 航行/飛行模式

🛒 台灣推薦購買通路與搜尋關鍵字：
🔗 良興電子 (EcLife)：搜尋「MTS (https://www.eclife.com.tw/) 搖頭開關 6mm」
🔗 廣華電子商城：搜尋「MTS-123 (https://www.guanghua.tw/) 搖頭開關 3檔」
🔗 今華電子：搜尋「MTS-102」與「MTS-123」 (https://www.jin-hua.com.tw/)

💡 引擎開關務必選擇 `(ON)-OFF-(ON)` 帶括號自復位型號，放手後自動彈回中央 關閉檔。

WH148 B10K 旋轉電位器 ＋
Φ15mm 調音台旋鈕帽

WH148 B10K + 148型旋鈕
帽 (Φ15mm)
⚡ 核心規格：WH148 B10K 線性 (7mm螺紋/6mm花軸) ＋ 148型工程塑料旋鈕 帽（外徑Φ15mm×H13mm、直槽防滑、白線指示、免頂絲緊配合插拔）
📌 專案用途：面板左側配置 1 組，搭配 15mm 防滑旋鈕帽；Pin1/Pin3 接 3.3V/GND，Pin2 Wiper 直連 A0 類比腳（韌體映射 ±1000，LCD 顯示 ±40度）

🛒 推薦購買通路與搜尋關鍵字：
🔗 良興電子 / ICShop：搜尋「WH148 (https://www.eclife.com.tw/) 10K 旋轉電位器」與「15mm 旋鈕 帽」
🔗 廣華電子 / 今華電子：搜尋「WH148 (https://www.guanghua.tw/) 10K B型」與「電位器旋鈕帽 6mm」
🔗 1688 原廠直銷：搜尋「148型旋鈕帽 (https://detail.1688.com/offer/715640049122.html) 直徑15mm 高度13mm」

💡 電位器請指名「B10K 線性」，旋鈕帽選用「6mm 花軸緊配合」之 Φ15mm 調 音台防滑款。

1/4W 1% 精密金屬膜電阻 ＆ 100nF 陶
瓷消噪電容

10kΩ/20kΩ 1% +
0.1µF 50V
⚡ 核心規格：10kΩ (棕黑黑紅棕) 2支 ｜ 20kΩ (紅黑黑紅棕) 2支 ｜ 1% 五色環 高精度 ｜ 100nF (104) 50V 獨石/陶瓷電容 3顆 📌 專案用途：電阻將 APEM 0~5V 類比精準衰減至 0~3.33V 保護 ADC；電容並

聯於 A0~A2 分壓點與 Row H 地間，消除馬達高頻干擾

🛒 台灣推薦購買通路與搜尋關鍵字：
🔗 良興電子 (EcLife)：搜尋「金屬皮膜電阻 (https://www.eclife.com.tw/) 10K 1% / 20K 1%」與「獨石電容 104」
🔗 ICShop 台灣物聯網：搜尋「1/4W (https://www.icshop.com.tw/) 1% 金屬膜電阻」與「陶瓷電容 100nF」
🔗 廣華電子 / 今華電子：各門市現貨常備，單價約 (https://www.guanghua.tw/) NT$1~5 / 顆

⚠️ 分壓務必指名 1% 五色環金屬膜電阻（嚴禁5%碳膜）；濾波推薦抗震耐溫獨 石電容。

XH2.54 連接器端子線組
(3P/4P/6P) ＆ 2.54mm 排針

JST-XH 2.54mm 直針公座
+ 帶線母插頭
⚡ 核心規格：XH2.54 3P×2 (雙推桿)、4P×1 (螢幕)、6P×1 (面板按鈕) ｜ 15~20cm 軟排線 ｜ 2.54mm 40P 單排直公針 📌 專案用途：焊裝於洞洞板邊緣，作為所有外接面板元件的可拆卸防呆插座，

維修更換推桿無需動烙鐵

🛒 台灣推薦購買通路與搜尋關鍵字：
🔗 ICShop 台灣物聯網：搜尋「XH2.54 (https://www.icshop.com.tw/) 帶線」、「XH2.54 直針座」、 「2.54mm 排針 40P」
🔗 蝦皮購物 (台灣現貨)：搜尋「XH2.54 (https://shopee.tw/) 帶線插頭 3P 4P 6P」
🔗 良興電子 / 廣華電子：各類接頭排針規格齊全 (https://www.eclife.com.tw/)

💡 建議直接購買「已壓接好彩排線的成品插頭」，線長 15~20cm 最為理想，省 下端子鉗手動壓線時間。

狀態螢幕 (×1) | 安全急停 (×1) | 控制開關 (×2)
向舵旋鈕 (×1) | 分壓與濾波組 | 端線材 (1套)
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
