snowhoster/MAVLinkController/sketch/chinese_fonts.h

// Generated Chinese 16x16 font bitmaps
#ifndef CHINESE_FONTS_H
#define CHINESE_FONTS_H

#include <Arduino.h>

const uint8_t ch_font_bitmaps[][32] PROGMEM = {
  { 0x00, 0x00, 0x02, 0x00, 0x02, 0x00, 0x3F, 0xFC, 0x04, 0x00, 0x04, 0x00, 0x08, 0x00, 0x0F, 0xF8, 0x10, 0x80, 0x30, 0x80, 0x20, 0x80, 0x00, 0x80, 0x1F, 0xFC, 0x00, 0x00, 0x00, 0x00, 0x00, 0x00 }, // '左' (index 0)
  { 0x00, 0x00, 0x01, 0x00, 0x03, 0x00, 0x3F, 0xFC, 0x02, 0x00, 0x04, 0x00, 0x0C, 0x00, 0x1F, 0xF8, 0x34, 0x08, 0x04, 0x08, 0x04, 0x08, 0x07, 0xF8, 0x04, 0x08, 0x00, 0x00, 0x00, 0x00, 0x00, 0x00 }, // '右' (index 1)
  { 0x00, 0x00, 0x30, 0x40, 0x08, 0x40, 0x03, 0xFC, 0x22, 0x44, 0x12, 0x44, 0x02, 0x44, 0x03, 0xFC, 0x1A, 0x44, 0x12, 0x44, 0x12, 0x44, 0x33, 0xFC, 0x22, 0x04, 0x00, 0x00, 0x00, 0x00, 0x00, 0x00 }, // '油' (index 2)
  { 0x00, 0x00, 0x3E, 0x7C, 0x22, 0x44, 0x3E, 0x7C, 0x22, 0x44, 0x3E, 0x7C, 0x20, 0x04, 0x20, 0x04, 0x20, 0x04, 0x20, 0x04, 0x20, 0x04, 0x20, 0x04, 0x20, 0x1C, 0x00, 0x00, 0x00, 0x00, 0x00, 0x00 }, // '門' (index 3)
  { 0x00, 0x00, 0x01, 0x00, 0x01, 0x80, 0x3F, 0xFC, 0x06, 0x00, 0x06, 0x00, 0x07, 0xF8, 0x04, 0x08, 0x04, 0x08, 0x04, 0x08, 0x0C, 0x18, 0x18, 0x10, 0x30, 0x70, 0x00, 0x00, 0x00, 0x00, 0x00, 0x00 }, // '方' (index 4)
  { 0x00, 0x00, 0x03, 0x00, 0x02, 0x00, 0x1F, 0xF8, 0x10, 0x08, 0x17, 0xE8, 0x14, 0x28, 0x14, 0x28, 0x14, 0x28, 0x17, 0xE8, 0x10, 0x08, 0x10, 0x08, 0x10, 0x38, 0x00, 0x00, 0x00, 0x00, 0x00, 0x00 }, // '向' (index 5)
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
  { 0x00, 0x00, 0x08, 0x40, 0x11, 0xF8, 0x15, 0x08, 0x25, 0xF8, 0x79, 0x08, 0x19, 0xF8, 0x10, 0x20, 0x2F, 0xA8, 0x7C, 0xB0, 0x00, 0xB0, 0x35, 0x28, 0x4A, 0x24, 0x48, 0xC0, 0x00, 0x00, 0x00, 0x00 }, // '線' (index 71)
};

// Mapping helper
inline int get_char_index(uint32_t unicode_val) {
  switch(unicode_val) {
    case 24038: return 0;
    case 21491: return 1;
    case 27833: return 2;
    case 38272: return 3;
    case 26041: return 4;
    case 21521: return 5;
    case 33333: return 6;
    case 35282: return 7;
    case 24341: return 8;
    case 25806: return 9;
    case 21855: return 10;
    case 21205: return 11;
    case 38364: return 12;
    case 38281: return 13;
    case 23450: return 14;
    case 20301: return 15;
    case 34907: return 16;
    case 26143: return 17;
    case 36895: return 18;
    case 24230: return 19;
    case 38651: return 20;
    case 37327: return 21;
    case 35338: return 22;
    case 34399: return 23;
    case 24310: return 24;
    case 36978: return 25;
    case 27169: return 26;
    case 24335: return 27;
    case 25163: return 28;
    case 23566: return 29;
    case 33258: return 30;
    case 20445: return 31;
    case 25345: return 32;
    case 35299: return 33;
    case 37782: return 34;
    case 19978: return 35;
    case 28961: return 36;
    case 31680: return 37;
    case 32622: return 38;  // 置
    case 36890: return 39;  // 通
    case 26412: return 40;  // 本
    case 27231: return 41;  // 機
    case 32202: return 42;  // 緊
    case 24613: return 43;  // 急
    case 20572: return 44;  // 停
    case 27490: return 45;  // 止
    case 24050: return 46;  // 已
    case 20999: return 47;  // 切
    case 26039: return 48;  // 斷
    case 25511: return 49;  // 控
    case 21046: return 50;  // 制
    case 27402: return 51;  // 權
    case 21462: return 52;  // 取
    case 24471: return 53;  // 得
    case 37323: return 54;  // 釋
    case 25918: return 55;  // 放
    case 35531: return 56;  // 請
    case 27714: return 57;  // 求
    case 20013: return 58;  // 中
    case 25298: return 59;  // 拒
    case 32085: return 60;  // 絕
    case 26410: return 61;  // 未
    case 38283: return 62;  // 開
    case 20154: return 63;  // 人
    case 33337: return 64;  // 船
    case 36960: return 65;  // 遠
    case 31471: return 66;  // 端
    case 36953: return 67;  // 遙
    case 22120: return 68;  // 器
    case 33322: return 69;  // 航
    case 30436: return 70;  // 盤
    case 32218: return 71;  // 線
    default: return -1;
  }
}

#endif // CHINESE_FONTS_H
