snowhoster/MAVLinkController/(commit log)

2026-06-22 首次提交
2026-07-31 Rework LCD/web telemetry fields and align comms with DAS GCS reference
    - LCD: replace GPS fix status with lat/lon, comm IP:Port, local IP:Port,
    and rudder angle rows; add header control-authority badge
    - Add missing Chinese glyphs (置/通/本/機) for the new labels
    - Bridge update_display() signature extended to carry GPS position,
    remote/local IP:Port, and control-authority state to the MCU
    - Default local_port to 14551 (fixed, symmetric UDP socket) to match
    the DAS.Tests.UsvSimulator.Wpf reference convention
    - Web UI: surface actual local IP:Port in the connection diagnostics
    [chinese_fonts.h, lcd_display.h, main.py, mavlink_handler.py, sketch.ino]
2026-07-31 Fix update_display() string params for RPClite MsgPack deserialization
    RPClite's Unpacker can only deserialize into a String& (arduino::msgpack::str_t&),
    not a const char* — the latter has no writable storage for unpack() to target.
    This caused a template substitution failure at compile time for remote_ip/local_ip.
    [sketch.ino]
2026-08-07 Add physical controls (E-STOP, per-engine, authority) and 手動/定向 modes
    Hardware inputs, all debounced 25 ms on the M4 side:
    D2/D3 left/right engine toggles — either ON arms the vessel; a switched-off
    side is pinned to 1500. Gating lives in send_rc_override() so the web
    sliders are subject to the physical switches too.
    D4 control-authority button — short press requests, 2 s hold releases
    (and clears the E-STOP latch).
    D5 emergency stop, wired to an NC contact so a broken wire also trips it.
    Sequence: neutral x3 -> DISARM -> release control -> close socket ->
    latch. Order matters; nothing can be sent once the socket is gon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
    [chinese_fonts.h, lcd_display.h, main.py, mavlink_handler.py, sketch.ino]
2026-08-10 fix(lcd): clear ESTOP red background on refresh and align TFT pins with hardware setup
    [lcd_display.h, sketch.ino]
2026-08-10 Fix safety and correctness issues found in review of the controls work
    Safety:
    - Clearing an E-STOP now forces web control off. It could not be switched
    off while latched (_blocked_by_estop guards that handler), so it survived
    the stop and left the browser with sole authority over a vessel whose
    operator had just cleared the stop at the controller — the wheel and
    levers were dead.
    - Added a restart interlock. Clearing the latch no longer resumes motion:
    output is held neutral until the levers are back within 100 us of centre
    and both engine switches are off. Previously the first on_inputs after a
    clear re-applied whatever the levers were sitting at, so flip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
    [lcd_display.h, main.py, mavlink_handler.py, sketch.ino]
2026-09-04 feat(hardware): 規劃雙 APEM SN 推桿與 40x24 洞洞板正反面電路佈局並產出工程圖
    - 新增雙通道 APEM SN 霍爾效應 T-Bar 油門推桿支援 (A1 左油門, A2 右油門)
    - 洞洞板配置 10k:20k 1% 金屬皮膜電阻精密分壓與 100nF 濾波電容 (適配 3.3V ADC)
    - 調整實體控制腳位至 UNO Q 標準排針 (A3/A4 引擎開關, A5 控制模式, D20 急停開關, D21 飛行模式)
    - 獨立底層 18650 UPS 電池倉規劃 (短 Type-C 供電 UNO Q，排針 Pin 5 輸出 5V 總線)
    - 繪製 40x24 洞洞板逐孔座標電路 (正面元件/跳線圖、背面仰視鏡像焊接走線圖、孔位座標表)
    - 產出 5 頁正式硬體工程圖與焊接 SOP (docs/hardware_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
2026-09-04 feat(docs): 新增 13 大關鍵零件實物照片圖鑑與台灣採購指南並更新 7 頁 PDF
    - docs/hardware_diagram.html：新增第 6 頁與第 7 頁實物零件照片圖鑑與採購指南
    - 內嵌 13 項關鍵零件真實高解析縮圖 (Base64 + docs/images/)，確保離線 100% 不破圖
    - 提供完整台灣在地採購管道與關鍵字 (Mouser、DigiKey、ICShop、良興、蝦皮現貨、廣華、今華)
    - 每項零件提供核心規格、專案用途、接線說明與採購避坑重點
    - 重新匯出 docs/hardware_diagram.pdf (共 7 頁完整工程圖與採購手冊，5.73 MB)
    - 同步更新 README.md 文檔索引
2026-09-04 fix(docs): 逐一嚴格比對並更換為 100% 正確的真實零件實物照片圖鑑
    - 重新嚴格人工逐一比對 13 項零件實物圖鑑，替換先前抓取不準確之圖片
    - 實物照片全部採用型號與外觀 100% 吻合之標準型錄照片：
    * Arduino UNO Q：官方 STM32U585 + Qualcomm QRB2210 雙核主板全圖
    * 18650 UPS 模組：雙節電池槽 + Type-C 充放一體板 (非單純降壓板)
    * 18650 電池：Panasonic NCR18650B 經典綠皮 3400mAh 電芯
    * 萬用載板：FR-4 綠色雙面鍍錫 2.54mm 孔距玻纖板 (非老式晶片板)
    * LCD 1602：藍底白字 1602 + PCF8574 I2C 4P 背包板 (顯示 USV Controller)
    * 急停開關：LA16-11ZS 16mm 紅色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
2026-09-18 fix(sketch): 方向盤極性反轉、舵角改 ±40 度顯示、油門推桿行程校正
    - 方向盤電位計接線與舵向相反，加入 STEER_REVERSED 於來源端反轉，左負右正
    - LCD 舵角左右兩欄統一顯示 ±40 度，右欄不再顯示原始 ±1000 值
    - 油門推桿實測行程僅 26%~100% / 22%~100%，新增 ADC 端點校正常數
    展成 1000~2000 μs 全範圍，LCD 顯示 -100% ~ +100%（中間 0%）
    [lcd_display.h, sketch.ino]
2026-09-18 docs: 新增雙操舵旋鈕與切換開關、更換 LCD 為米羅科技 #400300、擴充施工手冊至 9 頁與 SOP 分解圖
    - README BOM 改為雙 WH148 操舵旋鈕 + MTS-102 切換開關，LCD 改為 Mirotek #400300
    - README 新增 9 頁施工手冊導覽表與外殼頂部操作面板人因工學佈局
    - hardware_diagram.html/pdf 新增第八、九頁 SOP-01~15 向量分解圖解，零件圖鑑改 3 欄版面
    - 新增米羅科技 3.2" TFT LCD 實物照片與縮圖
2026-09-18 docs: 移除誤植的雙操舵旋鈕與舵輪切換開關，改回單一 WH148 方向盤
    - README BOM 改回單一方向盤電位計，面板佈局圖與 A0 配線圖回復單一電位計接法
    - hardware_diagram.html 移除第一頁 (C) 雙旋鈕線束圖、右操舵旋鈕、舵輪切換開關
    左側開關列重排為 3 組，SOP-09 開孔圖同步改為單一旋鈕與 2 顆 6mm 開關孔
    - LCD 示意由「啟用舵輪」改為舵角讀值（±40度 左負右正）
    - 重新輸出 hardware_diagram.pdf（16 頁 → 15 頁）
2026-09-18 feat(calib): 網頁可設定 AI 比例轉換／反向與 DI ON/OFF 反向，校正下發 MCU 並持久化
    - sketch: AiCal 校正結構取代 #define 端點，ai_map() 以中點分段線性映射並支援反向；
    DebouncedInput 新增 invert，db_set_invert() 切換時同步消抖狀態避免憑空產生邊緣；
    新增 set_calib RPC；on_inputs 增送 ADC 原始值、DI 腳位電平／邏輯狀態、calib_loaded
    - main.py: 校正讀寫 python/input_calib.json，_sanitize_calib 夾限，_push_calib 下發 MCU，
    MCU 回報 calib_loaded=0（重開機）時自動重送；set_calib 於 ARMED／引擎 ON／急停閂鎖時拒絕
    - web: 中央欄新增可展開「Input Calibration 輸入校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
    [main.py, sketch.ino]
2026-09-18 fix(sketch): 前置宣告 DebouncedInput，修正 ai_map 提前導致自動原型早於結構定義的編譯錯誤
    [sketch.ino]
